Arcturus314/stm_all/logs/approachpiezowaveform/readme

captured using a Saleae Logic 8 on ch1-4 with a 5-1 resistor divider
