Arcturus314/stm_all/logs/Inoise/tianoise.png

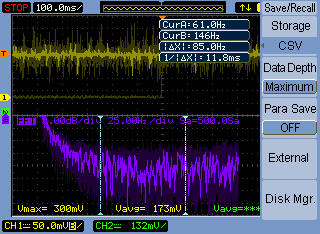
logs/Inoise/tianoise.png
