Arcturus314/stm_all/logs/Inoise_interrupts_duringscan/noshielding.png

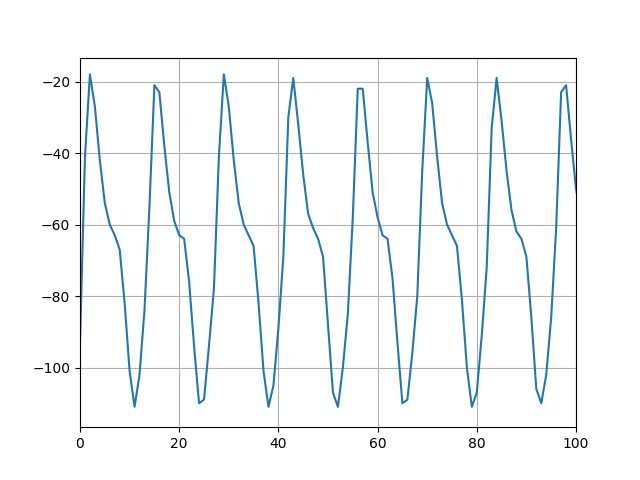
logs/Inoise_interrupts_duringscan/noshielding.png
