Arcturus314/stm_all/logs/Inoise_interrupts_duringscan/shieldedtiacable.png

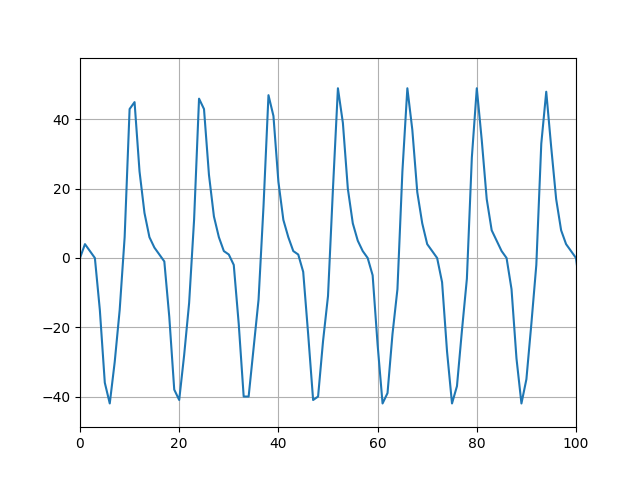
logs/Inoise_interrupts_duringscan/shieldedtiacable.png
