Arcturus314/stm_all/logs/oscilloscope_piezo/SDS00008.png

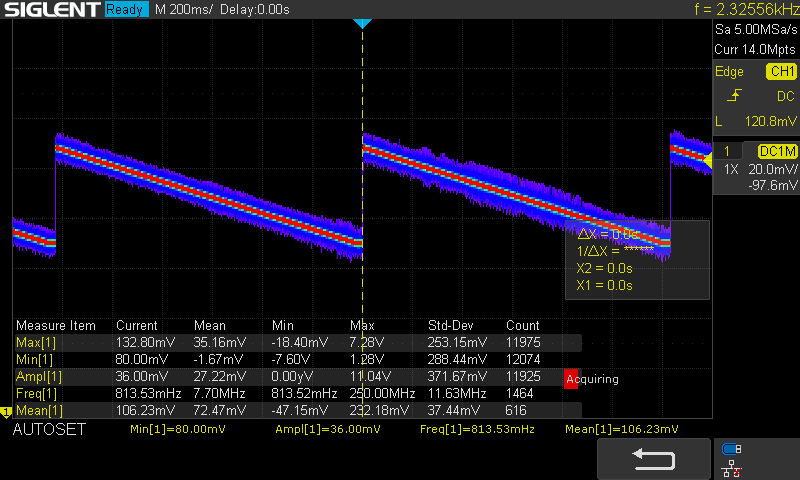
logs/oscilloscope_piezo/SDS00008.png
