Arcturus314/stm_all/logs/oscilloscope_piezo/SDS00009.png

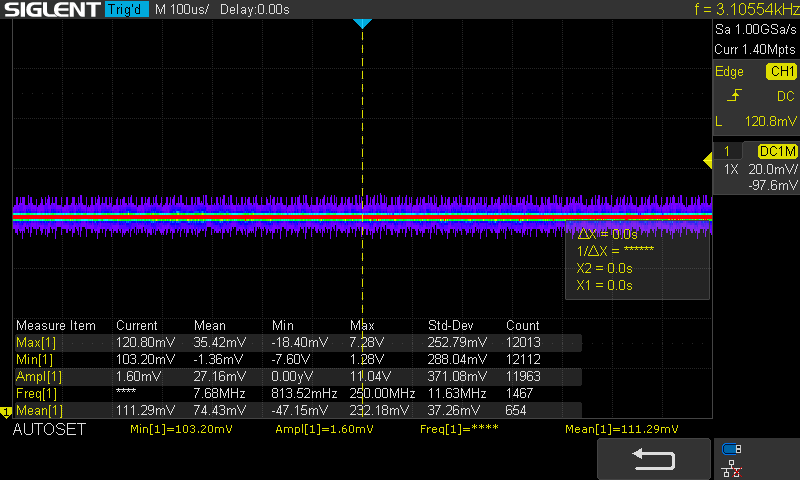
logs/oscilloscope_piezo/SDS00009.png
