Arcturus314/stm_all/logs/oscilloscope_piezo/SDS00010.png

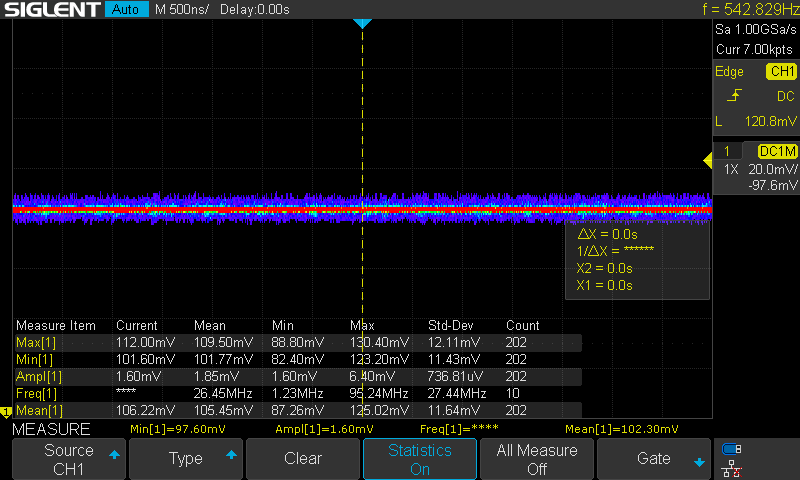
logs/oscilloscope_piezo/SDS00010.png
