Arcturus314/stm_all/logs/oscilloscope_piezo/SDS00011.png

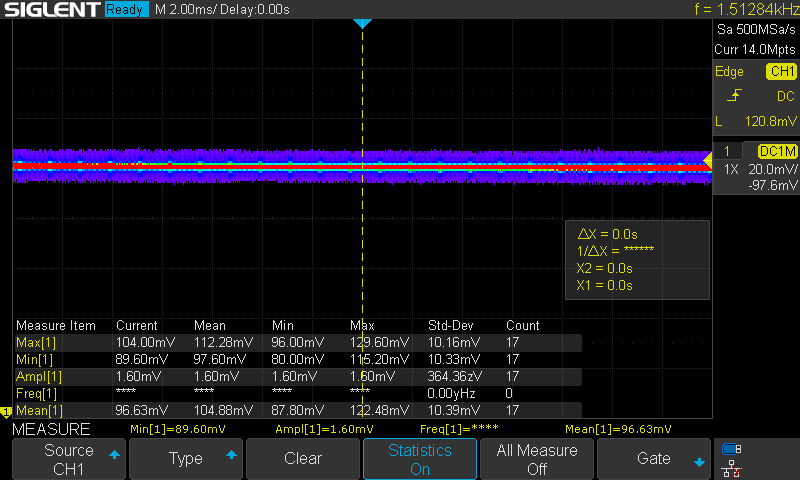
logs/oscilloscope_piezo/SDS00011.png
