Arcturus314/stm_all/logs/oscilloscope_piezo/SDS00012.png

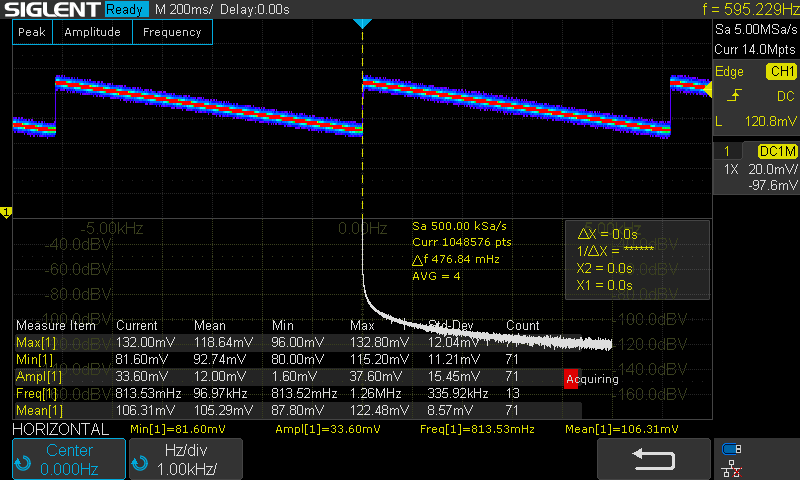
logs/oscilloscope_piezo/SDS00012.png
