Arcturus314/stm_all/logs/oscilloscope_piezo/SDS00013.png

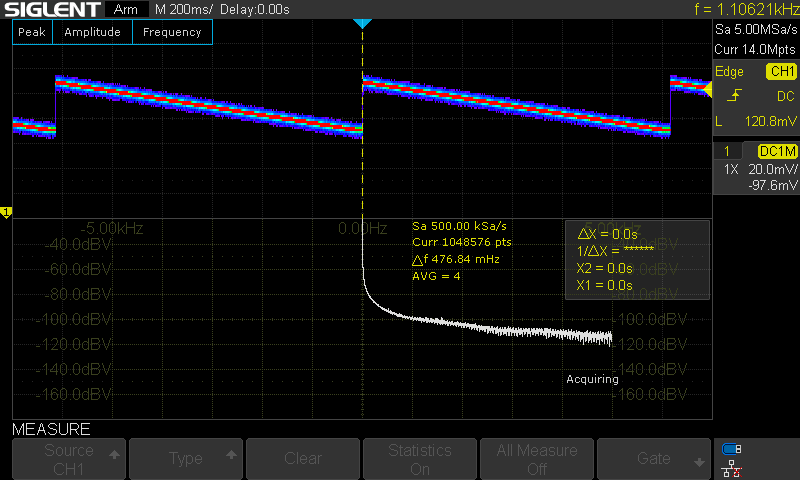
logs/oscilloscope_piezo/SDS00013.png
