Arcturus314/stm_all/logs/oscilloscope_piezo/SDS00014.png

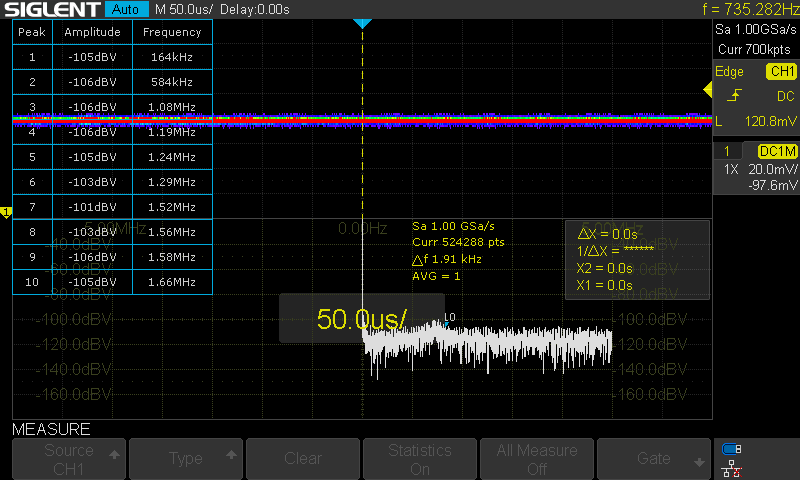
logs/oscilloscope_piezo/SDS00014.png
