Arcturus314/stm_all/logs/oscilloscope_tia/SDS00004.png

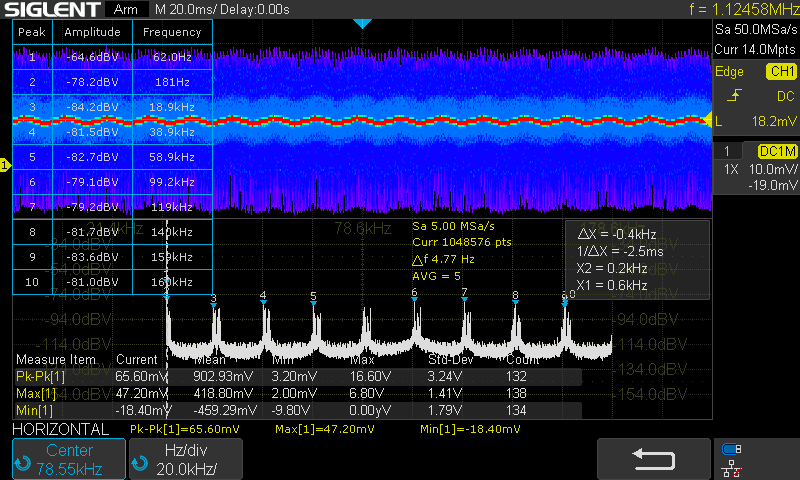
logs/oscilloscope_tia/SDS00004.png
