Arcturus314/stm_all/logs/oscilloscope_tia/SDS00005.png

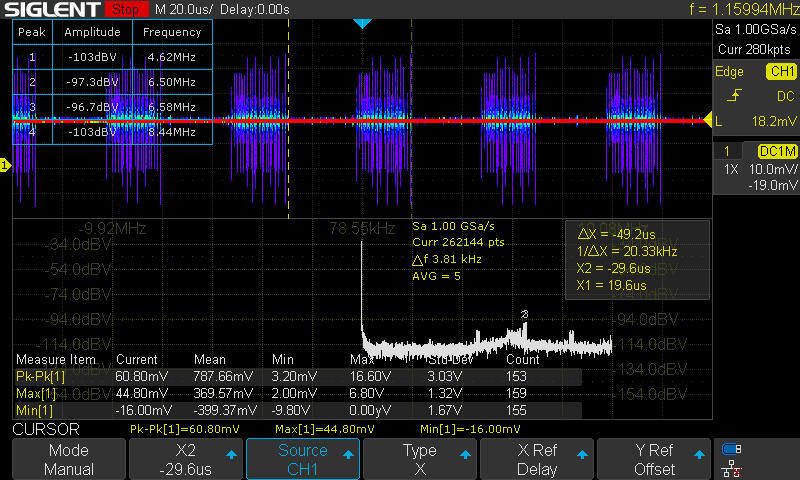
logs/oscilloscope_tia/SDS00005.png
