Arcturus314/stm_all/logs/oscilloscope_tia/SDS00006.png

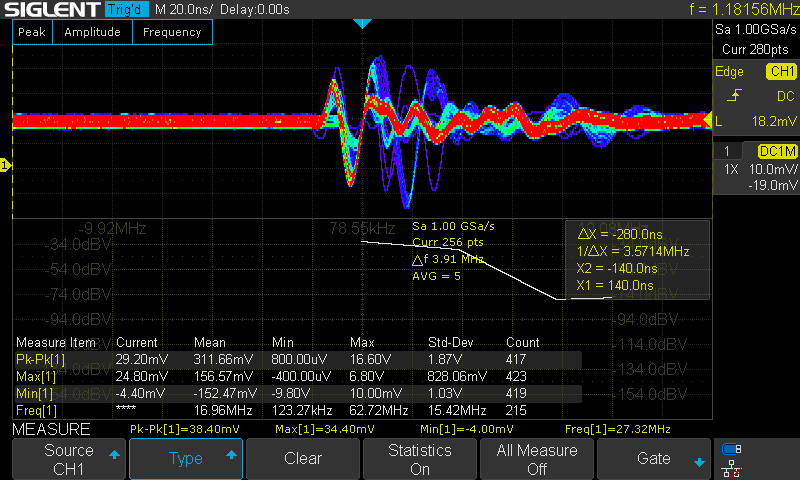
logs/oscilloscope_tia/SDS00006.png
