Arcturus314/stm_all/logs/oscilloscope_tia/SDS00007.png

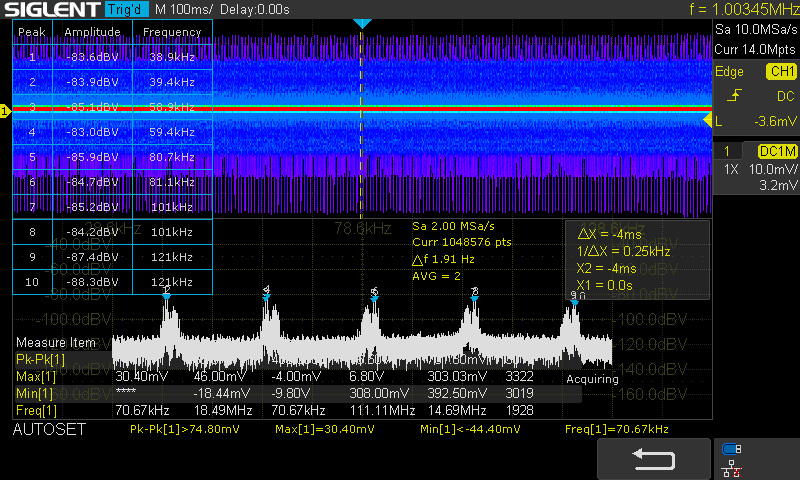
logs/oscilloscope_tia/SDS00007.png
