Arcturus314/stm_all/logs/oscilloscope_tia/TIANOISE.png

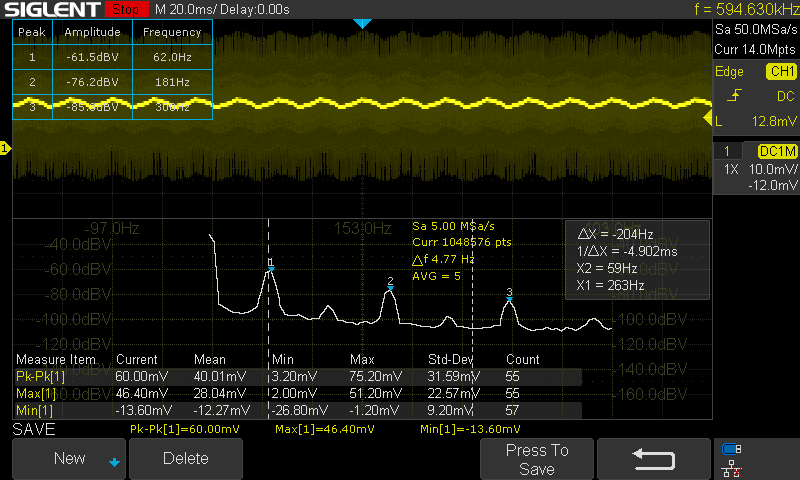
logs/oscilloscope_tia/TIANOISE.png
