Arcturus314/stm_all/stm/highvoltagedriver/IC_Microchip_MIC5281-5.0YMM-TR/eec.models/Microchip_-_MIC5281-5.0YMM-TR.step

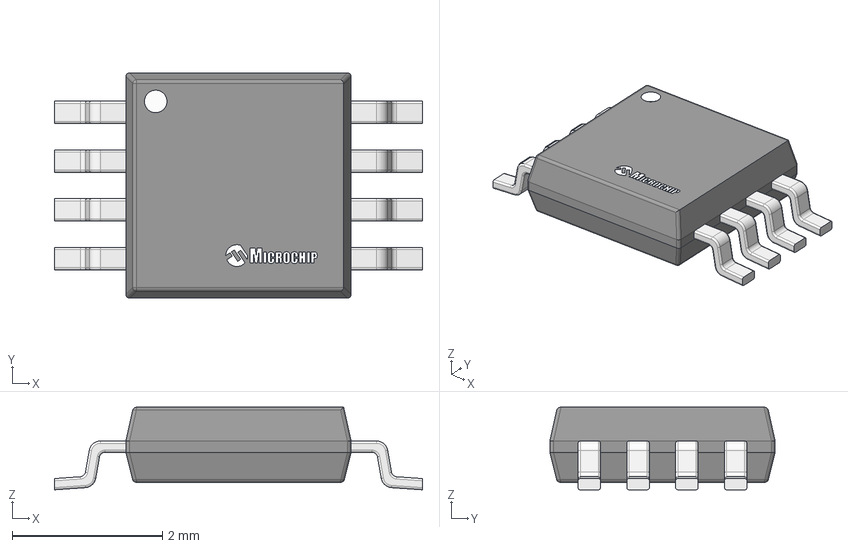
[picture p16: CAD file, 2021-03-22]
stm/highvoltagedriver/IC_Microchip_MIC5281-5.0YMM-TR/eec.models/Microchip_-_MIC5281-5.0YMM-TR.step
4.90 x 3.00 x 1.10 mm
IC_BODY
IC_LEG x 4
circle
Microchip logo
microchip
IC_LEG_MIR11 x 4
