Arcturus314/stm_all/stm/piezodriver/IC_Analog Devices_AD5628BRUZ-1REEL7/eec.models/Analog_Devices_-_AD5628BRUZ-1REEL7.step

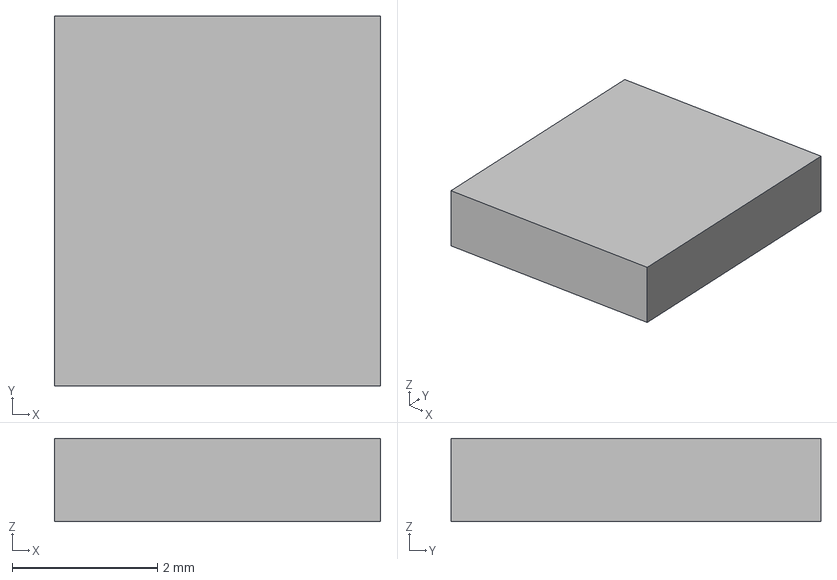
[picture p17: CAD file, 2021-03-22]
stm/piezodriver/IC_Analog Devices_AD5628BRUZ-1REEL7/eec.models/Analog_Devices_-_AD5628BRUZ-1REEL7.step
4.50 x 5.10 x 1.15 mm
