Arcturus314/stm_all/stm/basicpiezodrivercharacterization.xlsx

index | time | minutes | dateTime | voltage | predicted | diff | derivative
0 | 0.05 | 0.0008333333 | 1604285875 | 0 |  | 0
1 | 0.25 | 0.0041666667 | 1604285875 | 0 |  | 0 | 0
2 | 0.44 | 0.0073333333 | 1604285875 | 0 |  | 0 | 0
3 | 0.639 | 0.01065 | 1604285875 | 0 |  | 0 | 0
4 | 0.84 | 0.014 | 1604285876 | 0 |  | 0 | 0
5 | 1.03 | 0.0171666667 | 1604285876 | 0 |  | 0 | 0
6 | 1.229 | 0.0204833333 | 1604285876 | 0 |  | 0 | 0
7 | 1.429 | 0.0238166667 | 1604285876 | 0 |  | 0 | 0
8 | 1.607 | 0.0267833333 | 1604285876 | 0 |  | 0 | 0
9 | 1.807 | 0.0301166667 | 1604285877 | 0 |  | 0 | 0
10 | 2.007 | 0.03345 | 1604285877 | 0 |  | 0 | 0
11 | 2.199 | 0.03665 | 1604285877 | 0 |  | 0 | 0
12 | 2.39 | 0.0398333333 | 1604285877 | 0 |  | 0 | 0
13 | 2.597 | 0.0432833333 | 1604285877 | 0 |  | 0 | 0
14 | 2.797 | 0.0466166667 | 1604285878 | 0 |  | 0 | 0
15 | 2.987 | 0.0497833333 | 1604285878 | 0 |  | 0 | 0
16 | 3.184 | 0.0530666667 | 1604285878 | 0 |  | 0 | 0
17 | 3.376 | 0.0562666667 | 1604285878 | 0 |  | 0 | 0
18 | 3.585 | 0.05975 | 1604285878 | 0 |  | 0 | 0
19 | 3.778 | 0.0629666667 | 1604285879 | 0.004 |  | 0.004 | 0.004
20 | 3.983 | 0.0663833333 | 1604285879 | 0.004 |  | 0.004 | 0
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
