Arcturus314/stm_all/stm/testscripts/v2tiatest.xlsx

0.27403656 | 0.2742864219 | test, 5 samples | test, 1 sample | 0.05393 | 0.26965 | 0.27090908 | no current | 0.27535 | 0.274225 | 10mohm@3v | 0.58202 | 0.5878529666 | 0.3136279666 | v delta
0.2717807 | 0.00165688766 |  |  | 0.05379 | 0.26895 | 0.001996764405 |  | 0.26393 | 0.009566550505 |  | 0.57813 | 0.008707352292
0.2748825 |  |  |  | 0.05473 | 0.27365 |  |  | 0.27585 |  |  | 0.58998 |  | expect… | 1mohm gain resistor
0.27530548 |  |  |  | 0.05441 | 0.27205 |  |  | 0.28614 |  |  | 0.58845 |  |  | current | 3e-07
0.27174041 |  |  |  | 0.05349 | 0.26745 |  |  | 0.26197 |  |  | 0.57803 |  |  | v delta | 0.3
0.27458039 | 44.37822491 |  |  | 0.05415 | 0.27075 | 42.6499347 |  | 0.27581 | 29.14703353 |  | 0.591 | 36.58765196
0.2765744 |  |  |  | 0.05471 | 0.27355 |  |  | 0.29059 |  |  | 0.60081 |  | nice! Looks good
0.27359346 |  |  |  | 0.05399 | 0.26995 |  |  | 0.26747 |  |  | 0.57477
0.27262664 |  |  |  | 0.05421 | 0.27105 |  |  | 0.27474 |  |  | 0.59203
0.27474153 |  |  |  | 0.05381 | 0.26905 |  |  | 0.28582 |  |  | 0.59832
0.27675569 |  |  |  | 0.05399 | 0.26995 |  |  | 0.2694 |  |  | 0.58156 |  | can currently resolve
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
