Arcturus314/stm_all/stm/frontendamp/frontendfullv2/frontendfullv2/frontendfull_lm7721/schematics.pdf

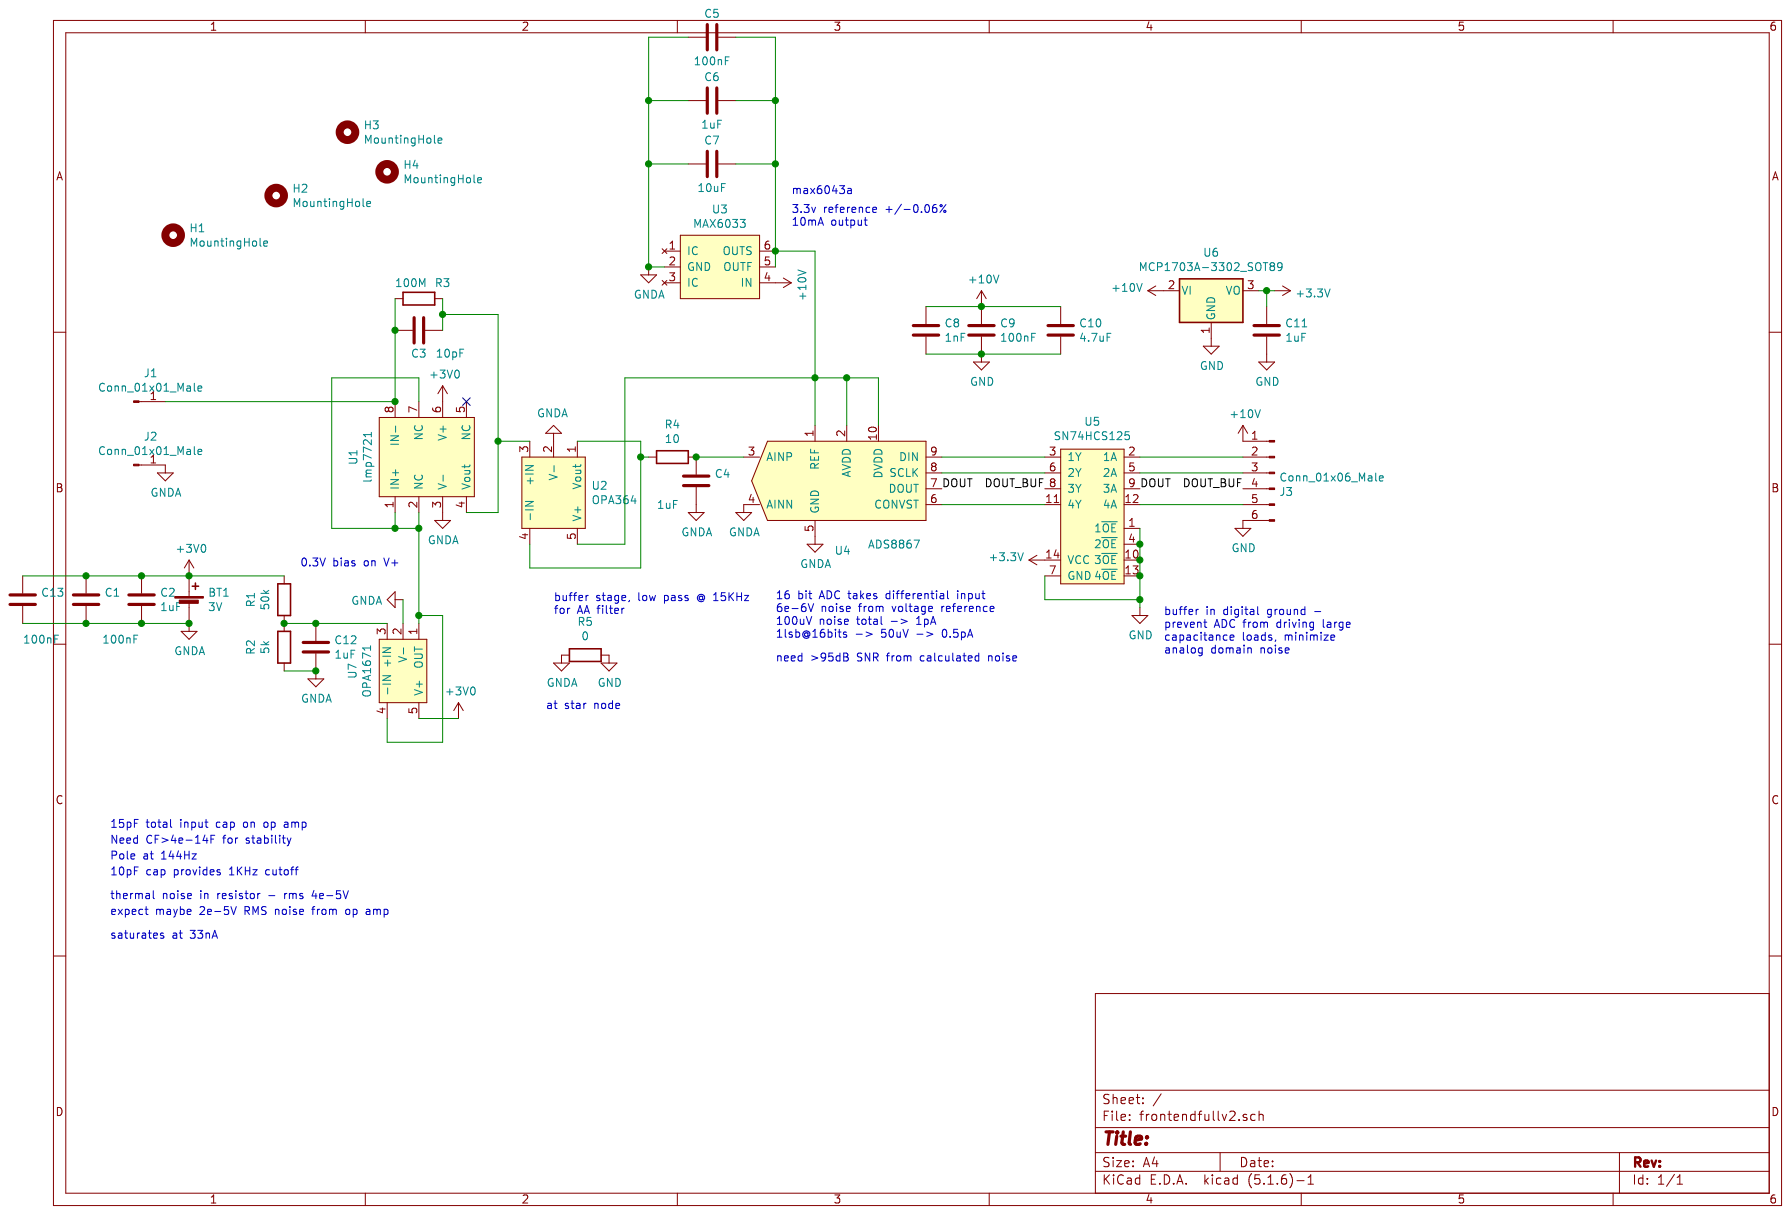
[picture p18: page 1]
