Arcturus314/stm_all/stm/highvoltagedriver/schem.pdf

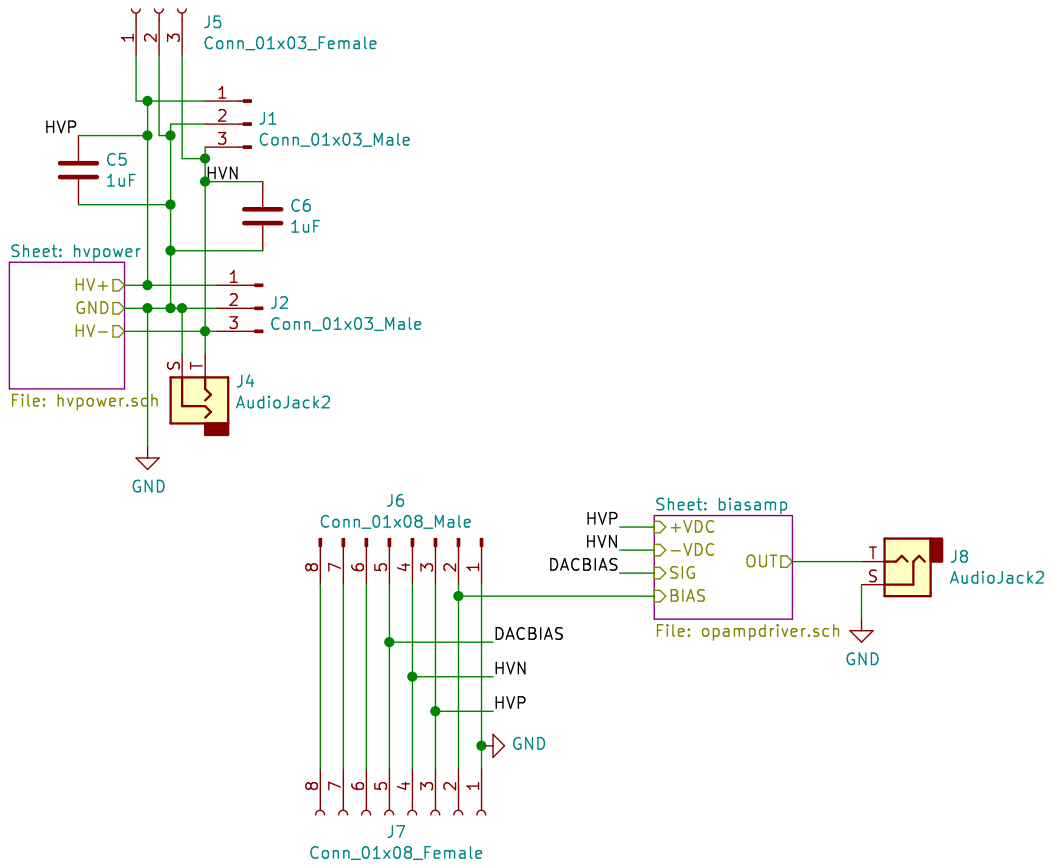
[picture p19: page 1]

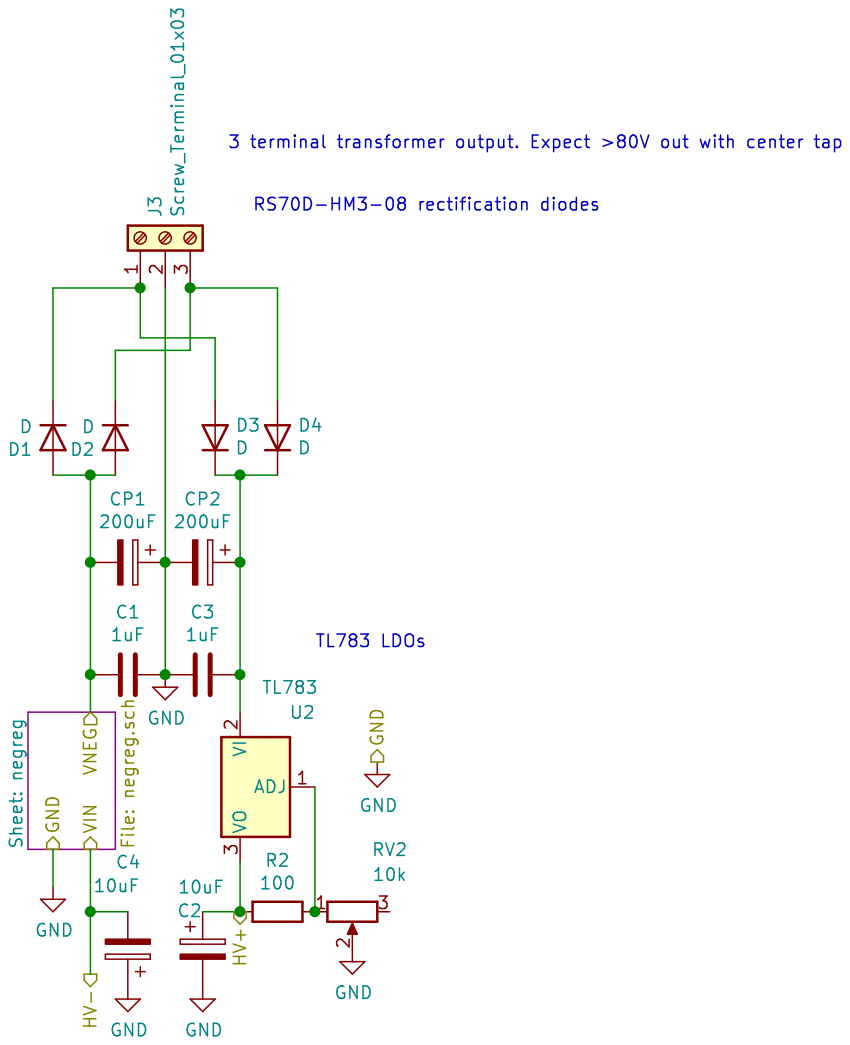
[picture p20: page 2]

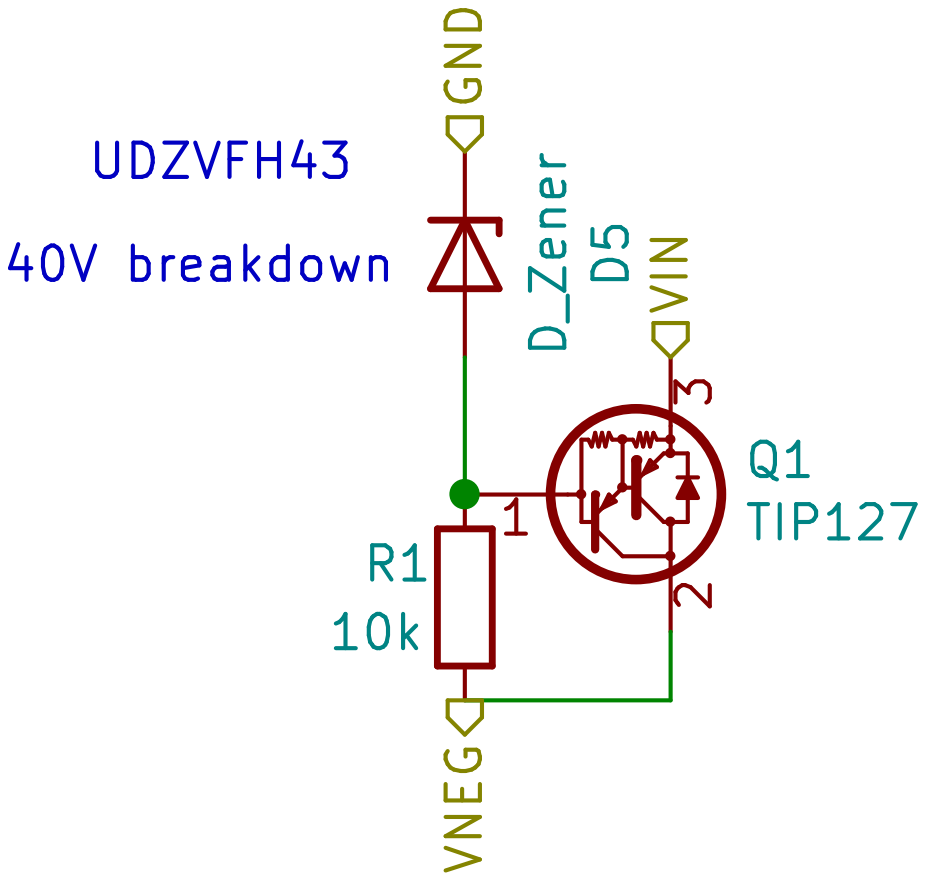
[picture p21: page 3]

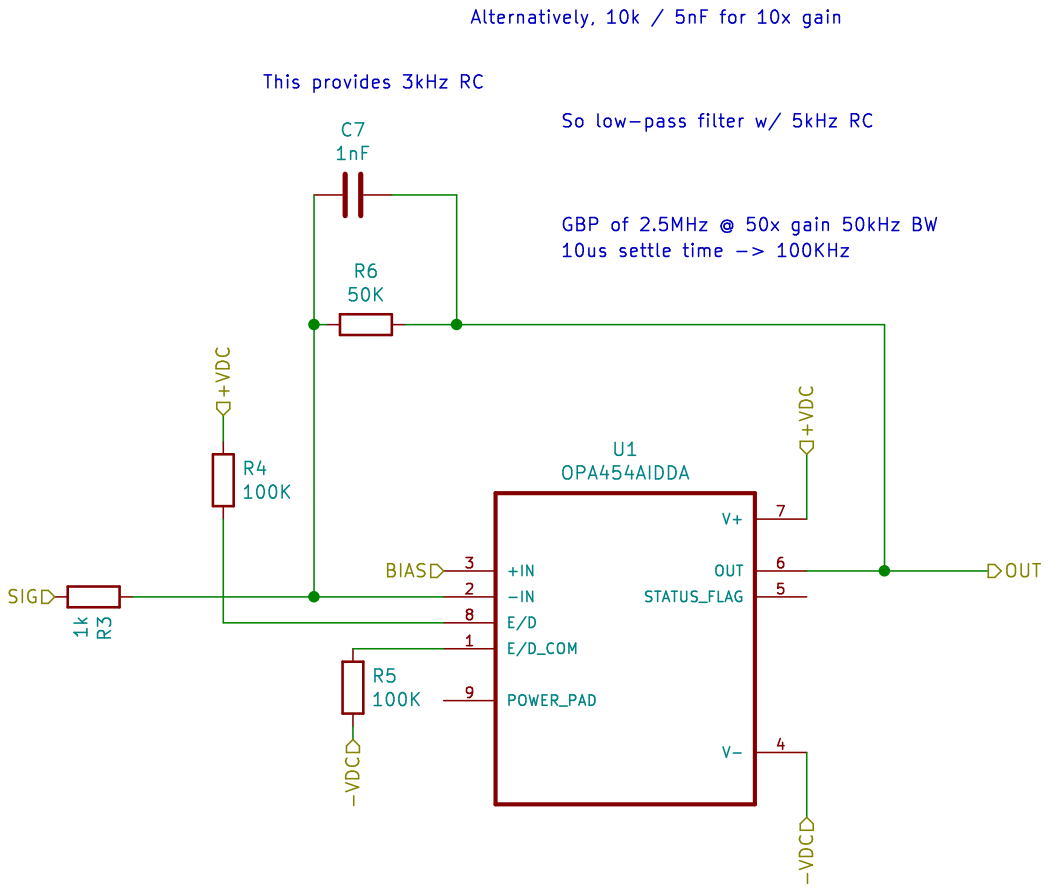
[picture p22: page 4]
