Arcturus314/stm_all/stm/highvoltagedriver/schemamp.pdf

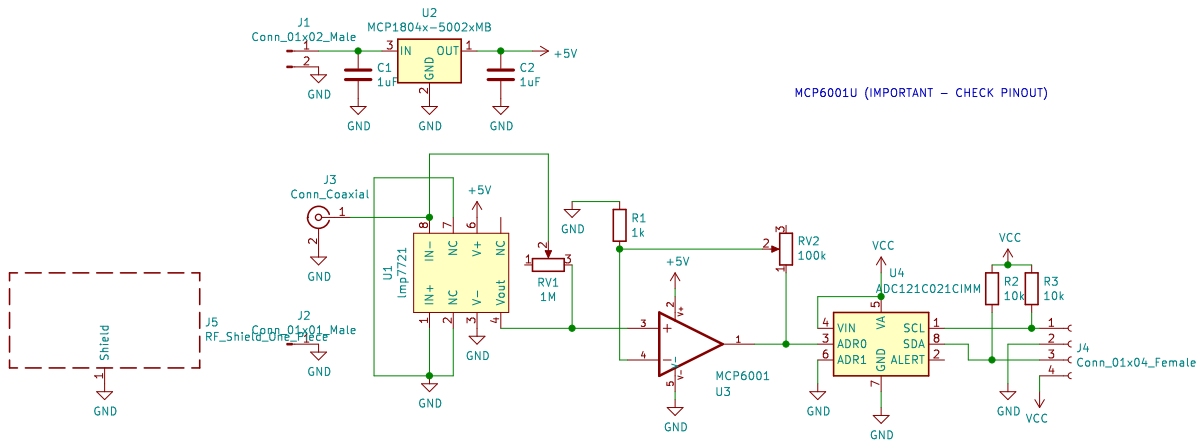
[picture p23: page 1]
