Arcturus314/stm_all/stm/highvoltagedriver/schempiezo.pdf

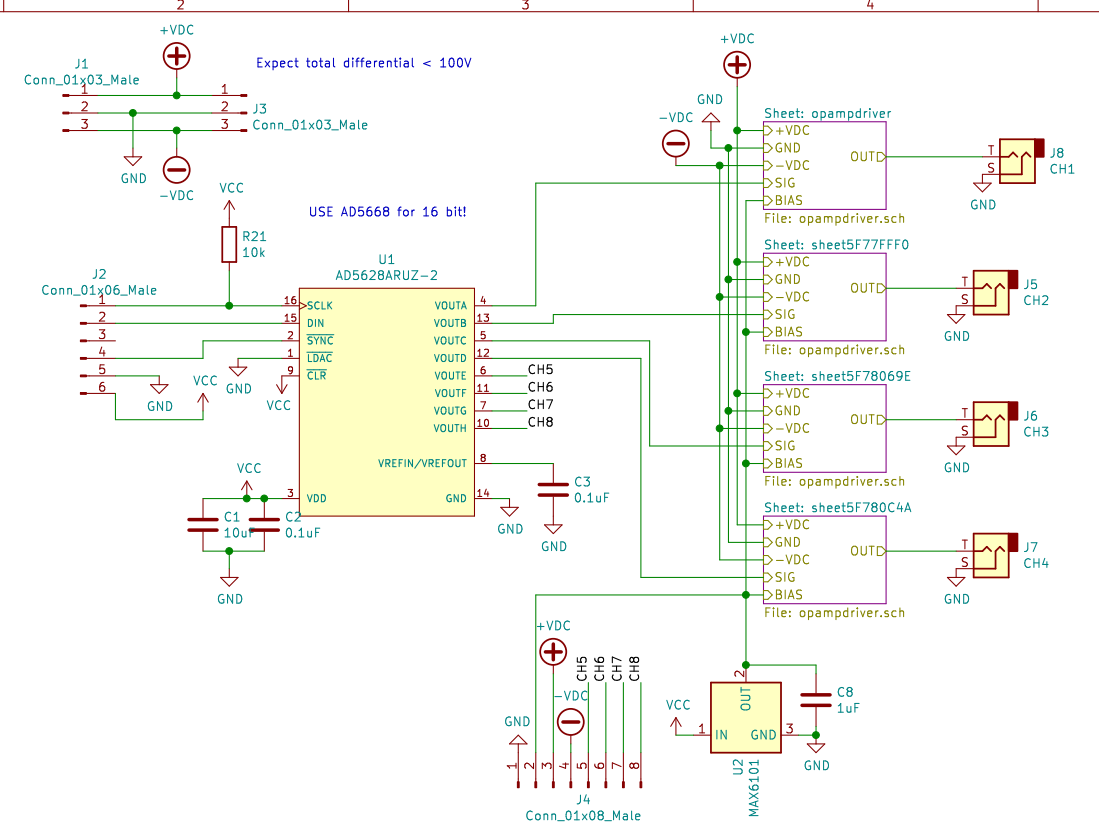
[picture p24: page 1]

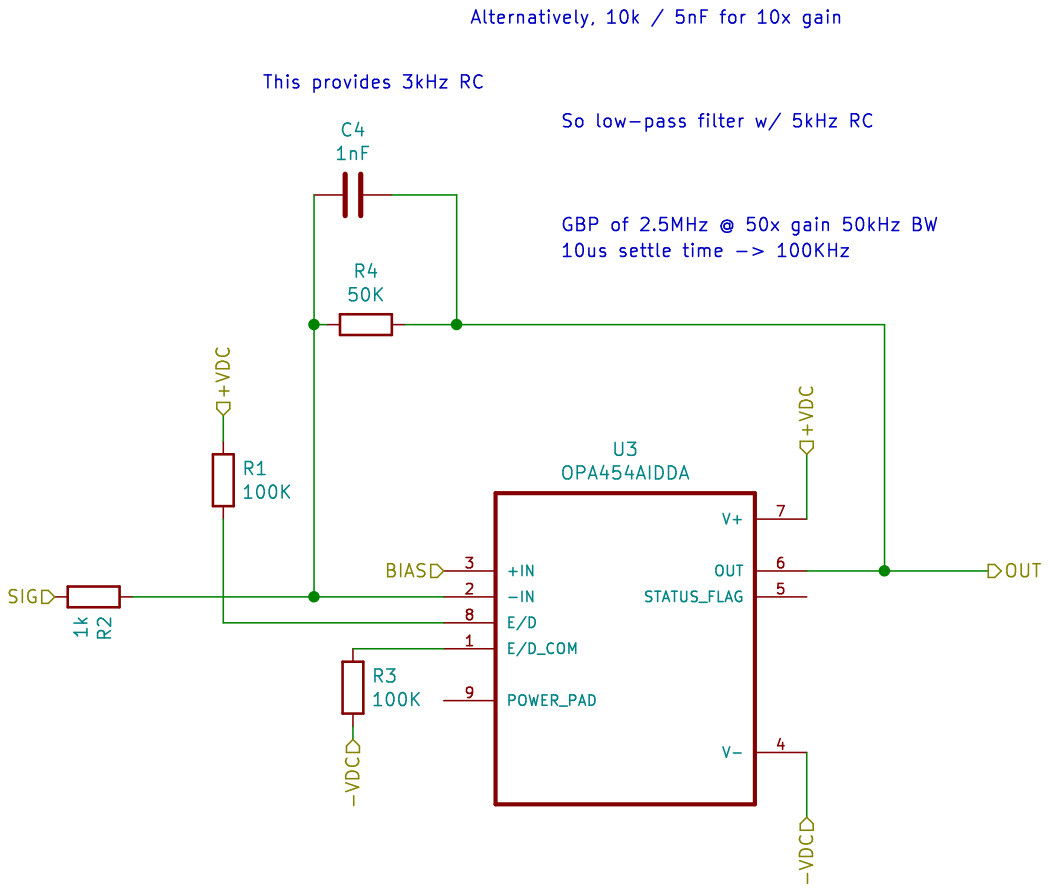
[picture p25: page 2]

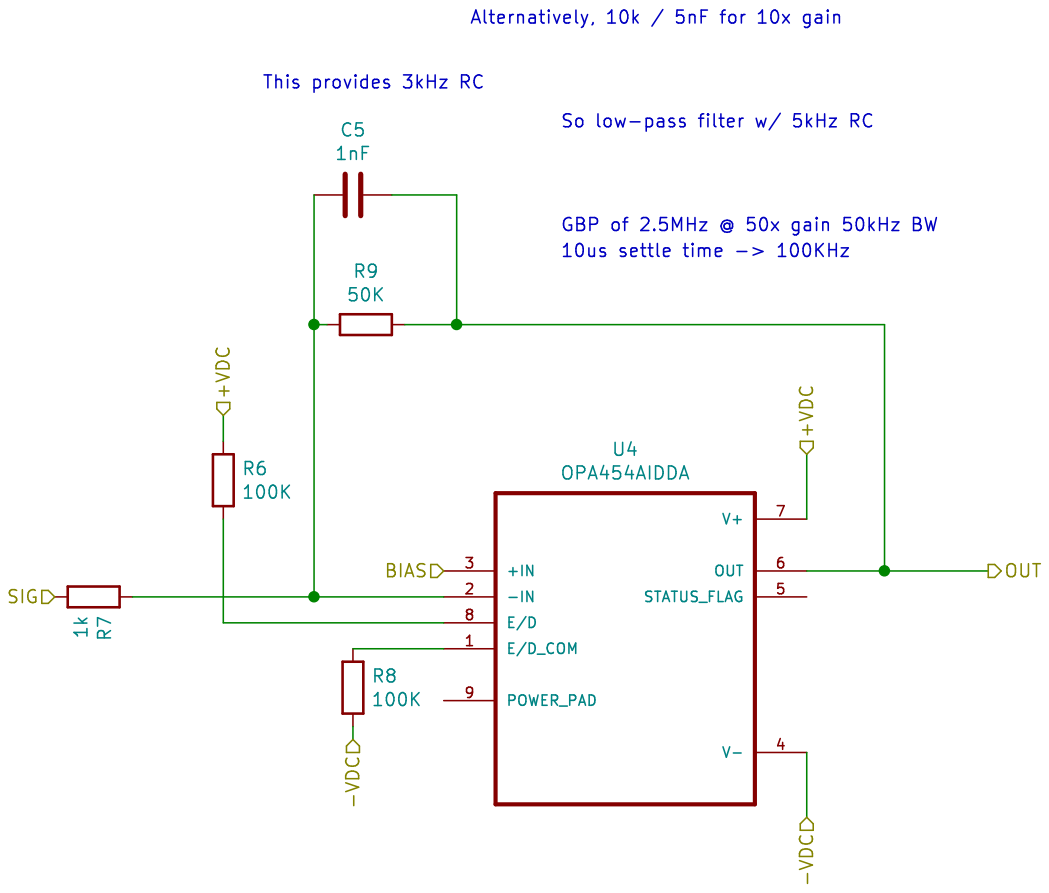
[picture p26: page 3]

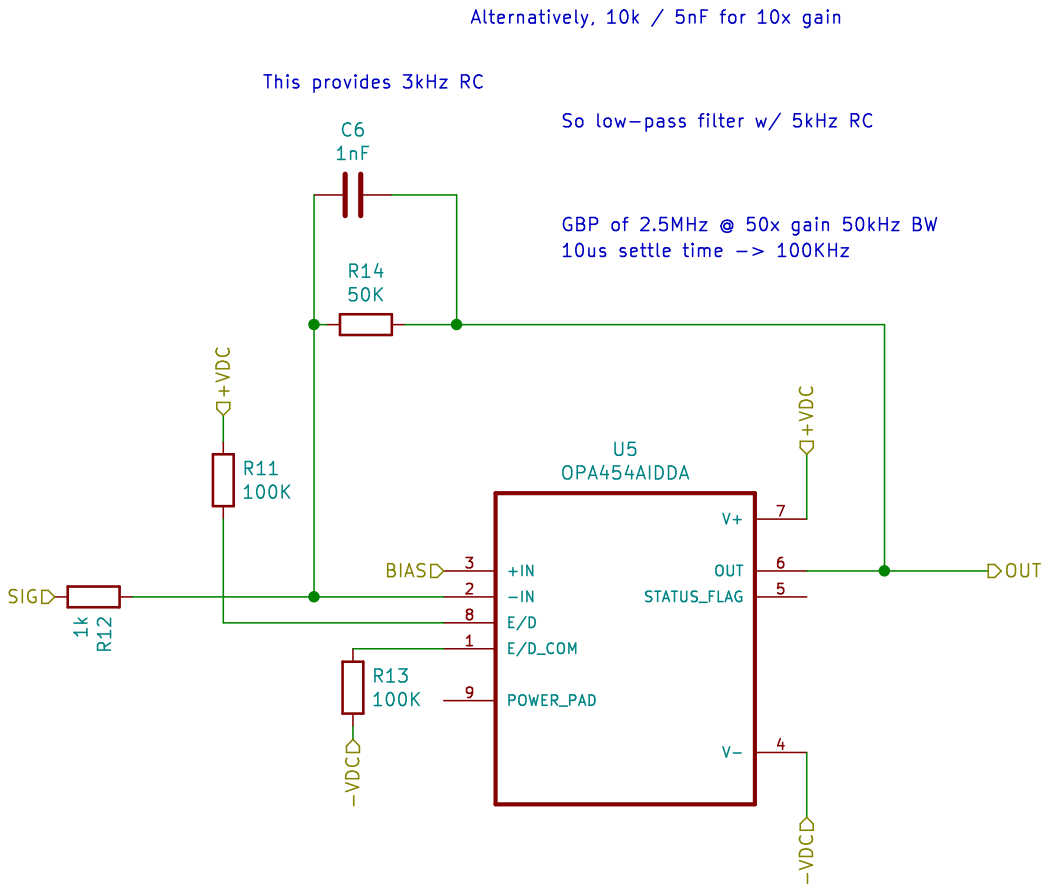
[picture p27: page 4]

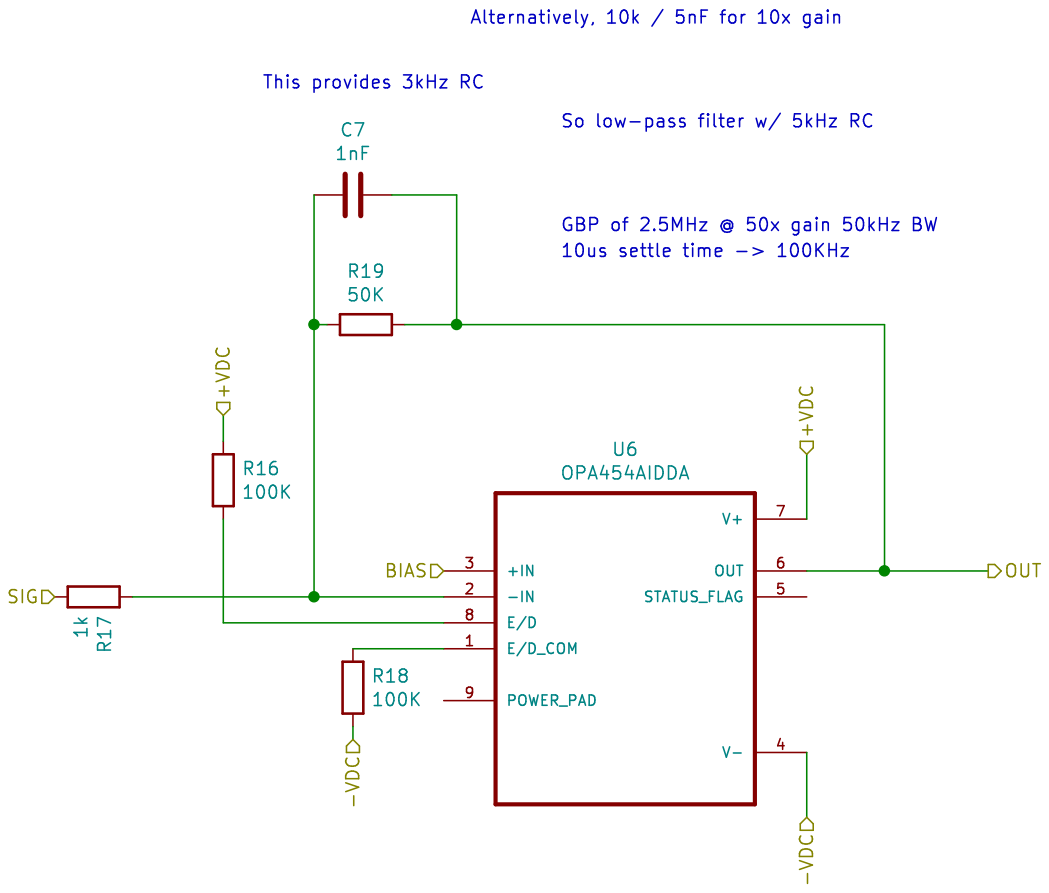
[picture p28: page 5]
