Arcturus314/stm_all/stm/userinterfacepcb/userinterfaceschem.pdf

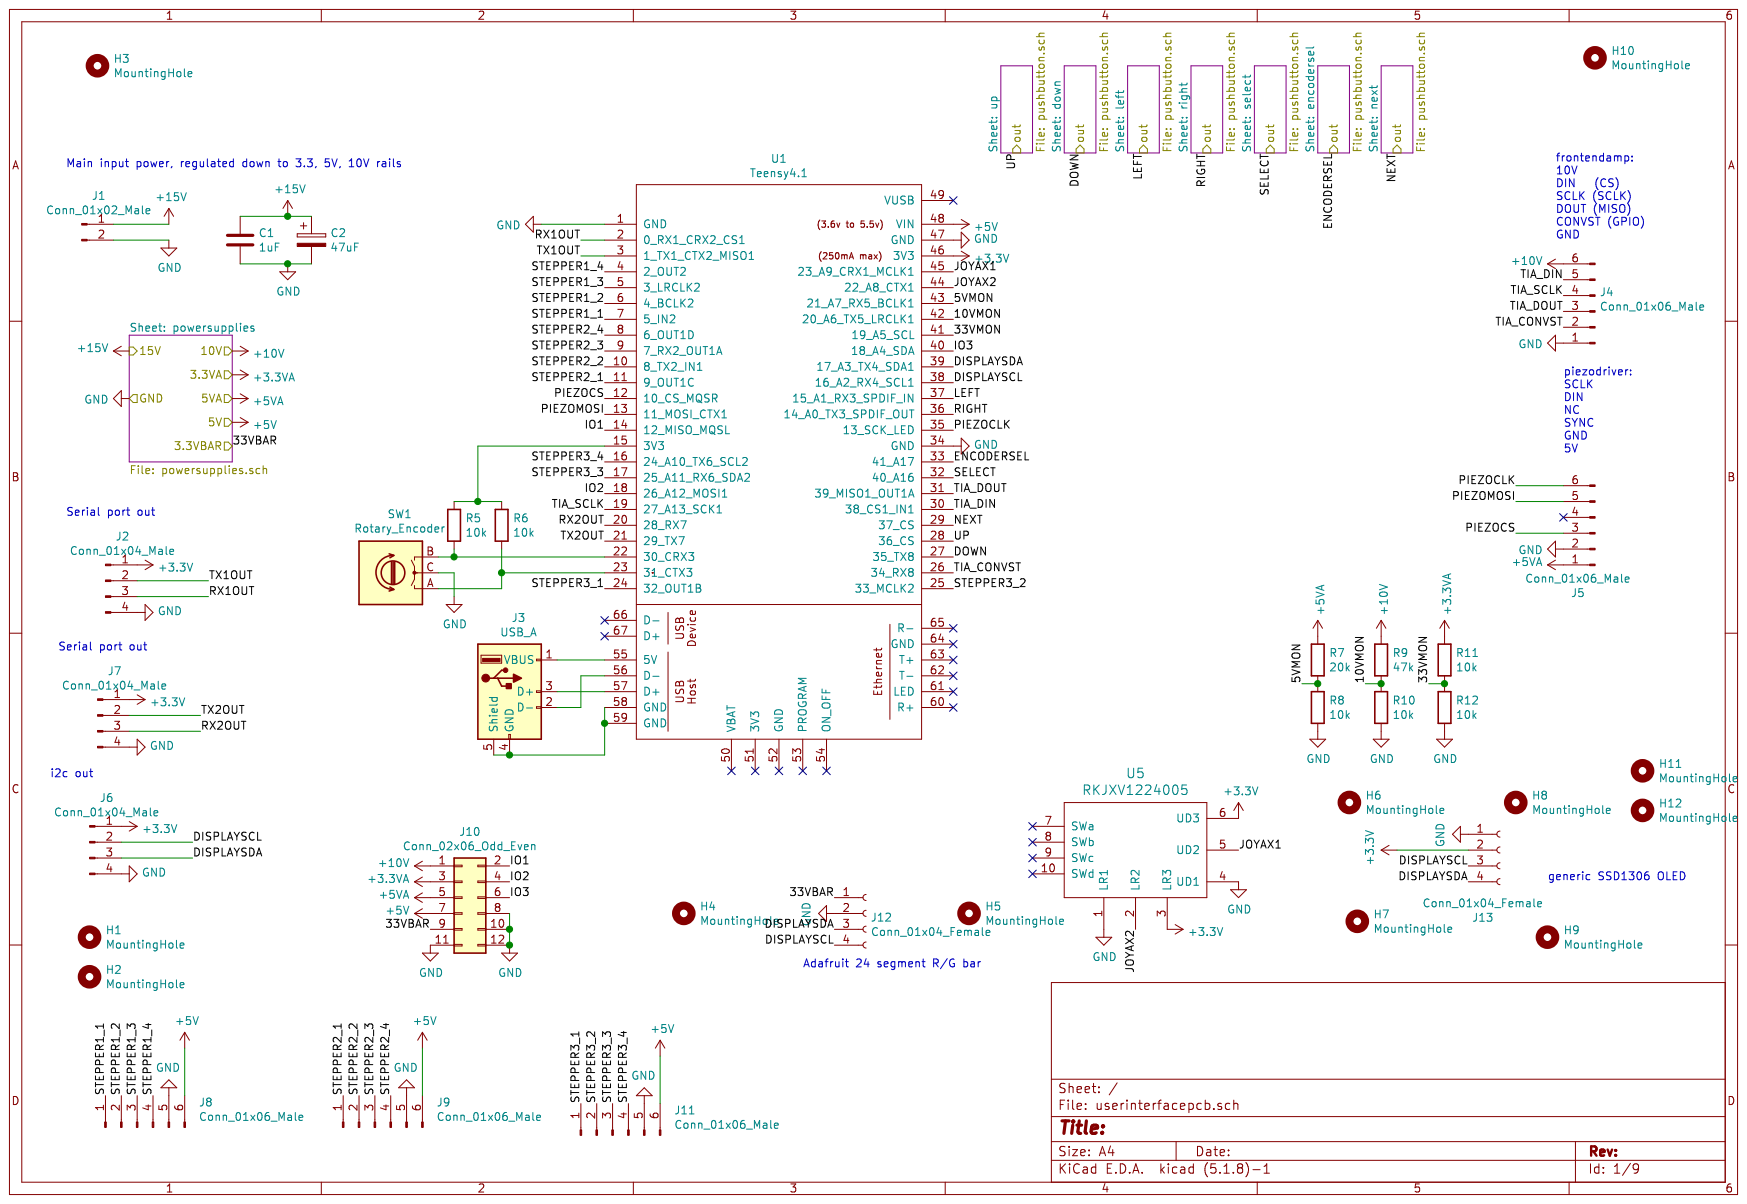
[picture p35: page 1]

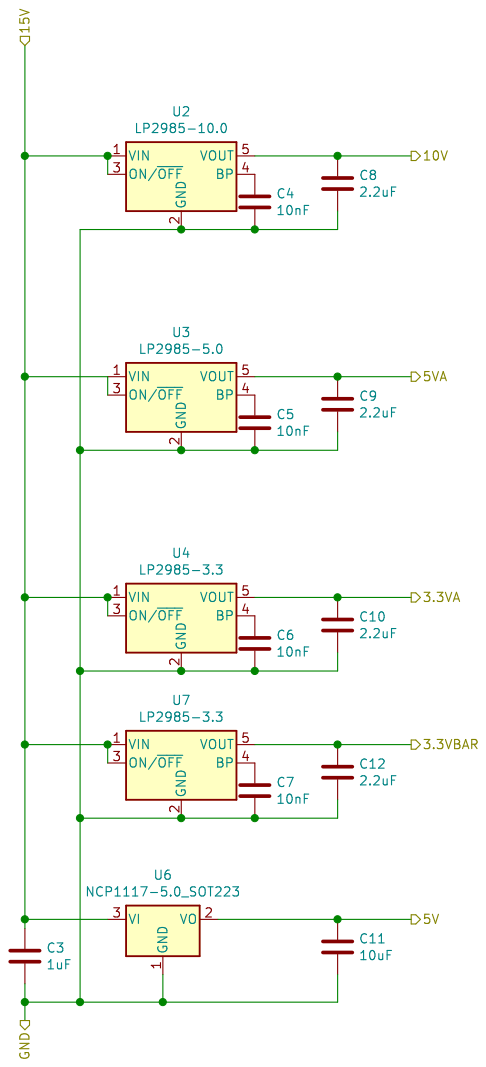
[picture p36: page 2]

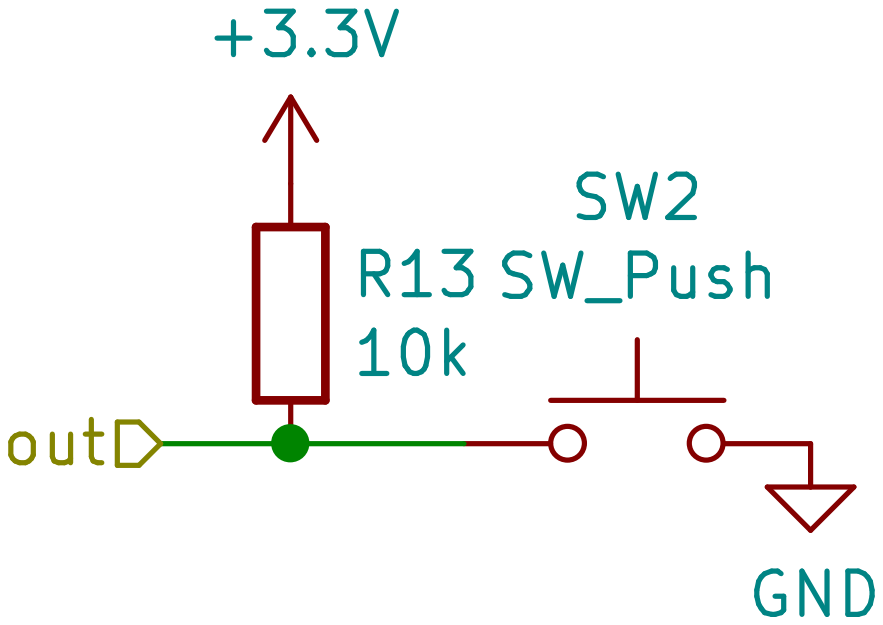
[picture p37: page 3]

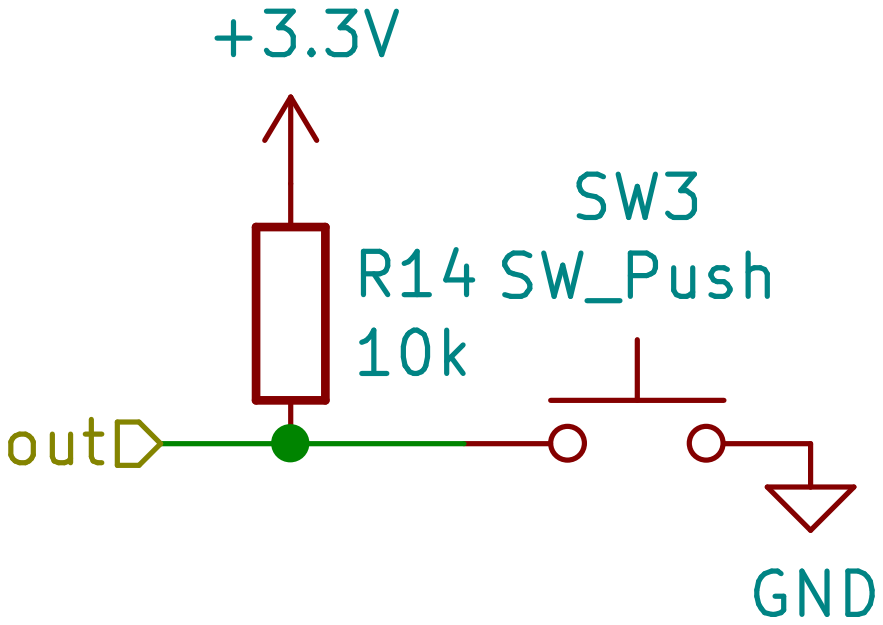
[picture p38: page 4]

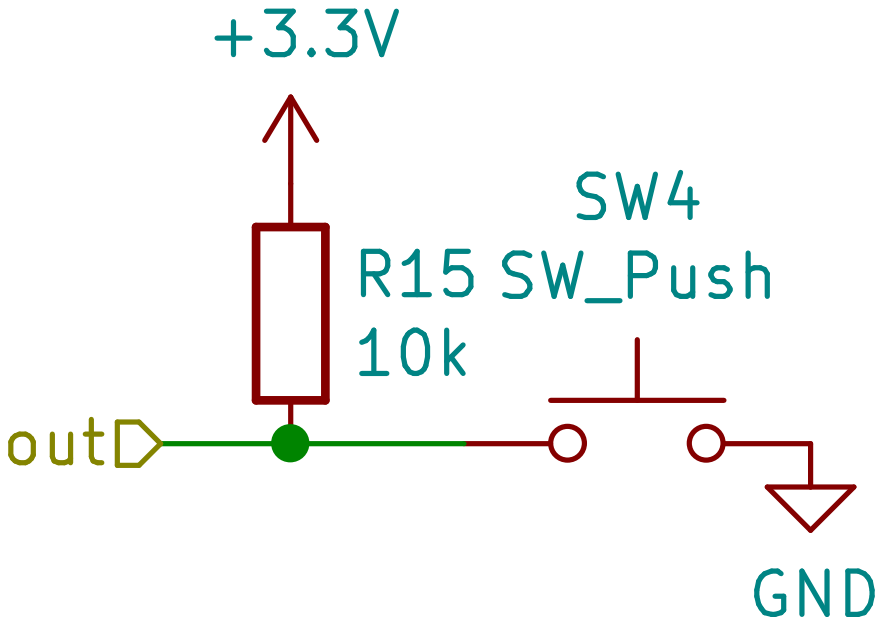
[picture p39: page 5]

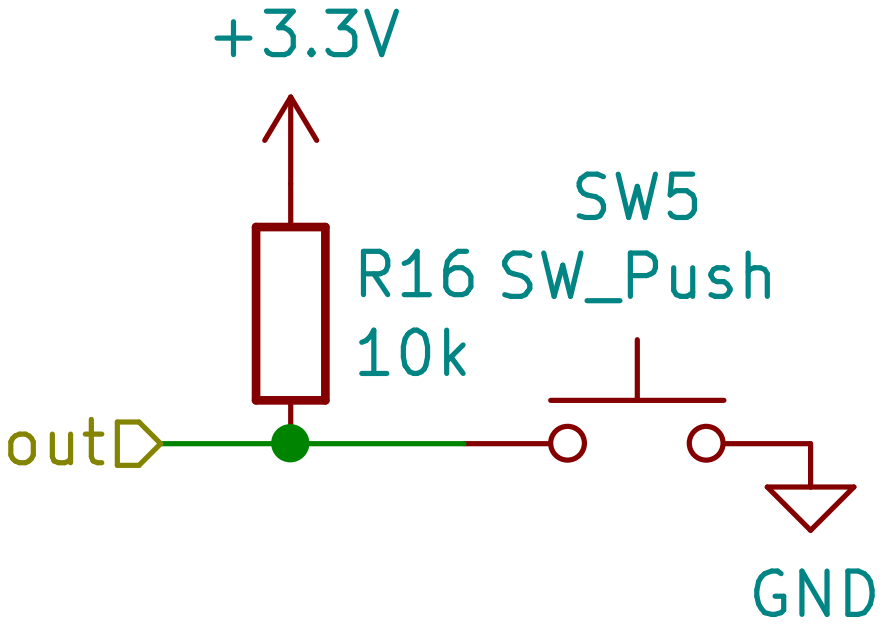
[picture p40: page 6]

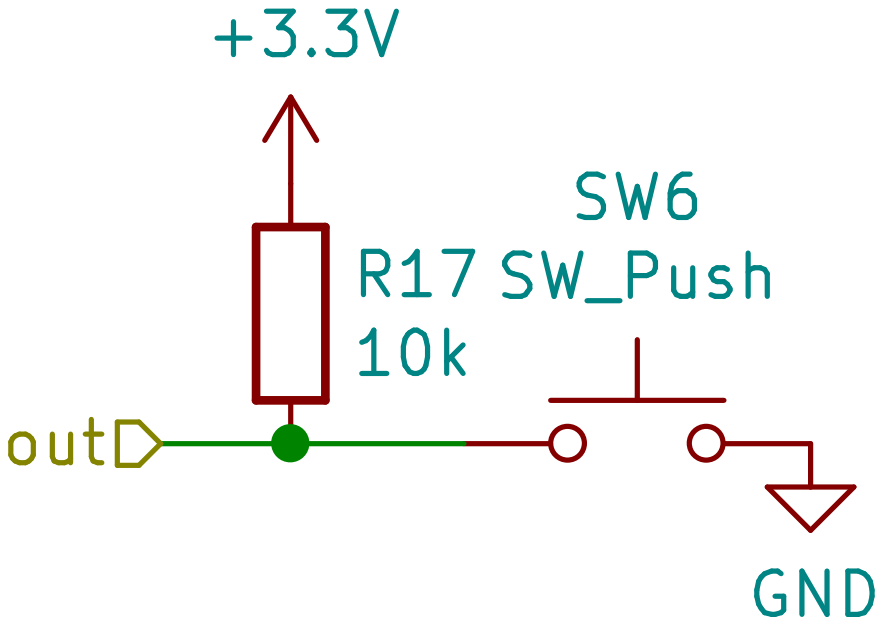
[picture p41: page 7]

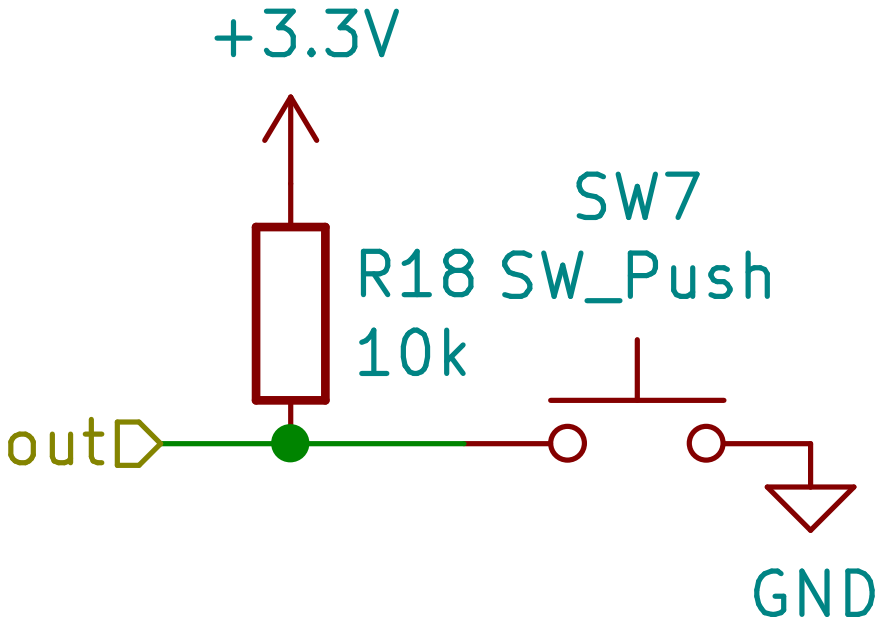
[picture p42: page 8]

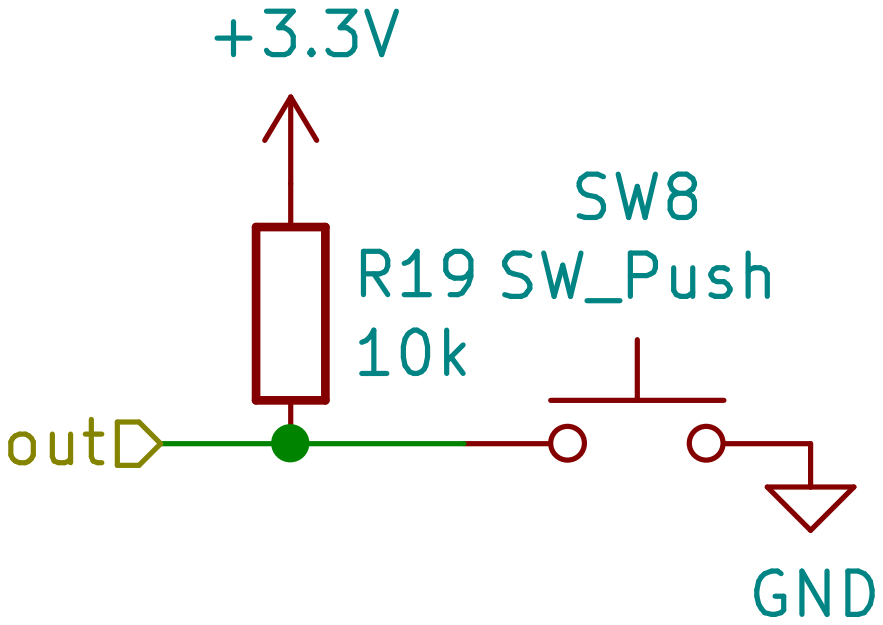
[picture p43: page 9]
