Arcturus314/stm_all/(list of files, drawings)

Other design files:
stm/userinterfacepcb/userinterfacepcb.dsn
