Arcturus314/stm_all/stm/piezodriverv2/piezodriver.kicad_pcb

## KiCad design stm/piezodriverv2/piezodriver.kicad_pcb (2021-03-22)

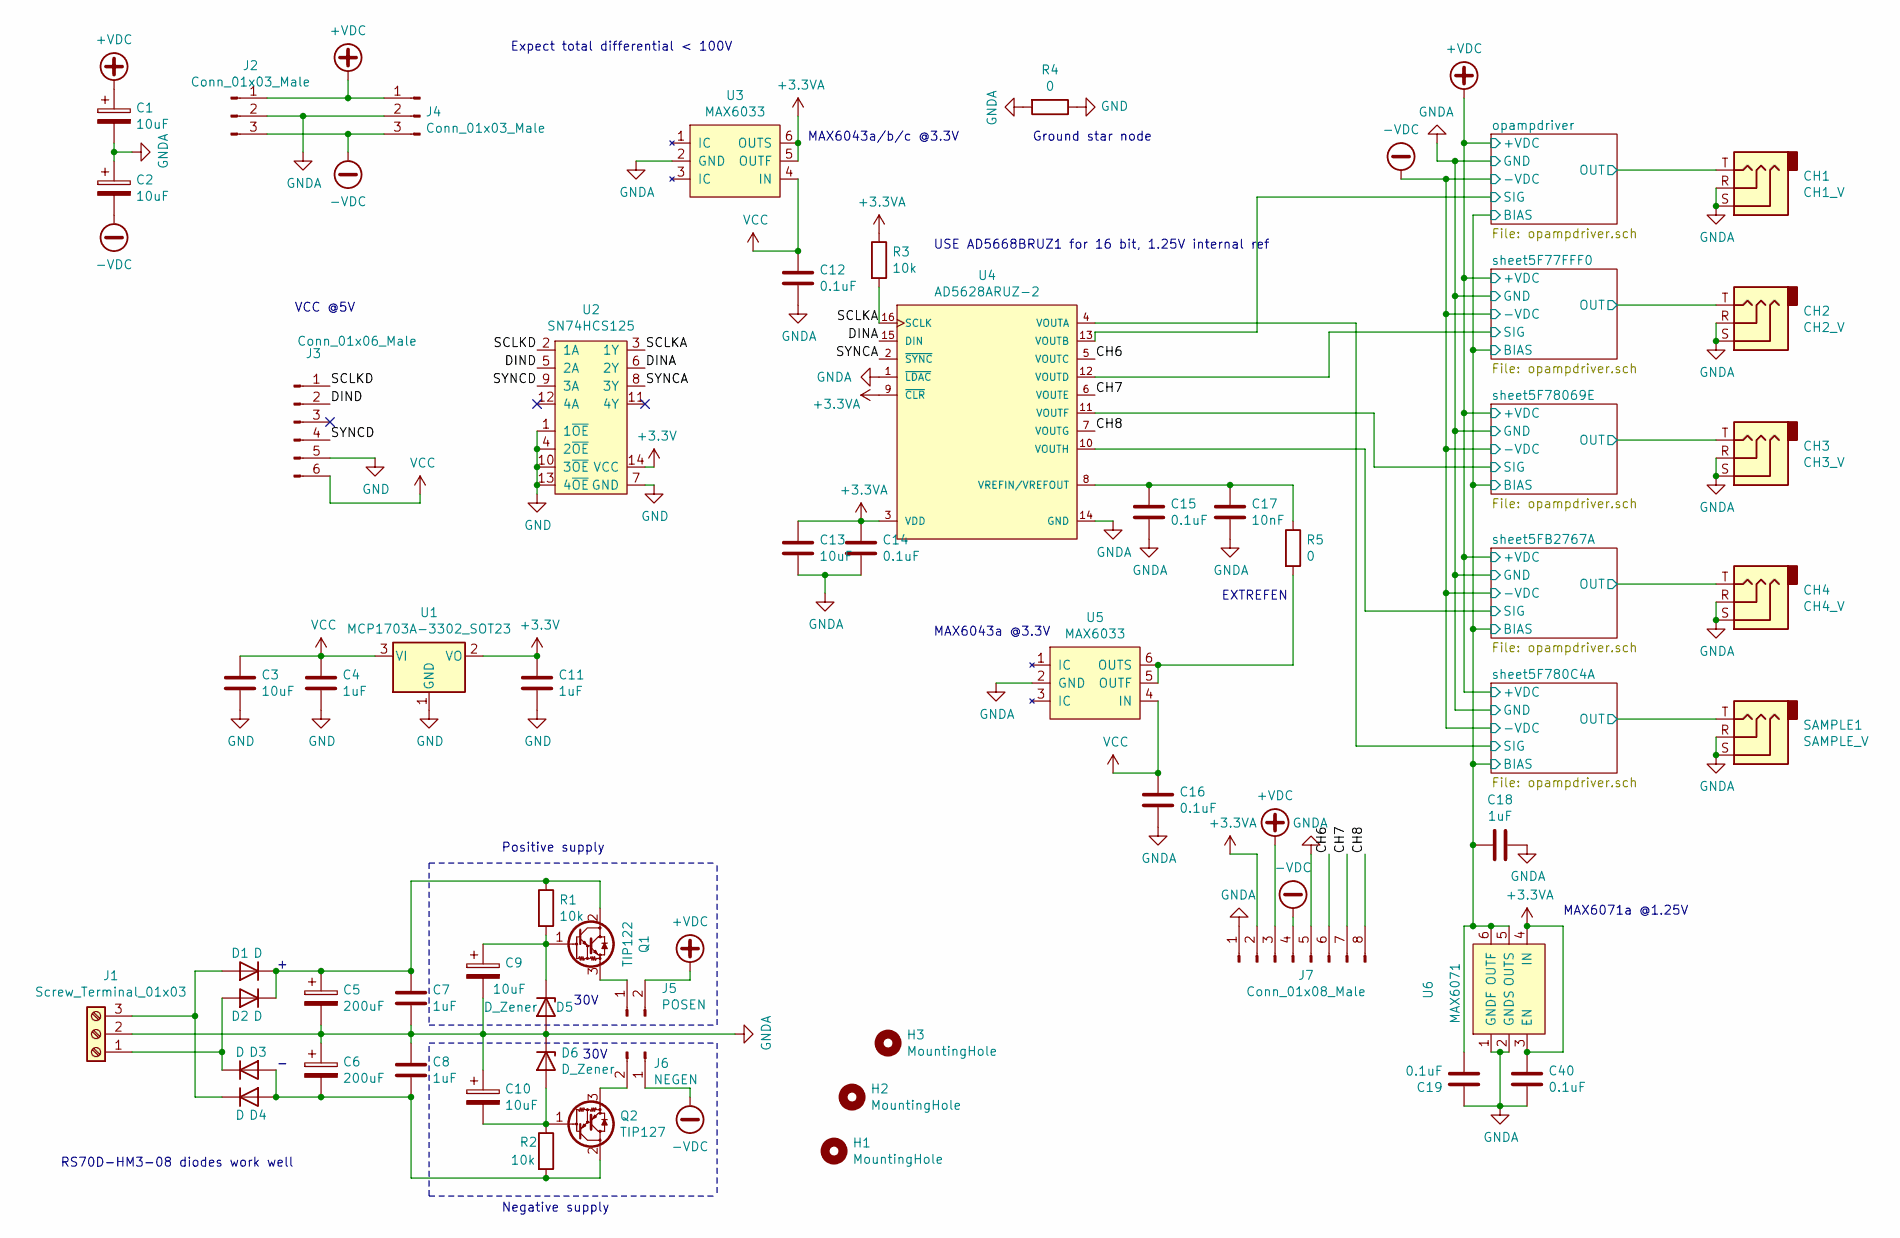
[picture p44: schematic piezodriver.sch]

Parts:
C1, C2, C9, C10: 10uF; CP_Radial_D5.0mm_P2.50mm
C3, C13: 10uF; C_0805_2012Metric_Pad1.18x1.45mm_HandSolder
C4, C7, C8, C11, C18: 1uF; C_0805_2012Metric_Pad1.18x1.45mm_HandSolder
C5, C6: 200uF; CP_Radial_D12.5mm_P5.00mm
C12, C14, C15, C16, C19, C40: 0.1uF; C_0805_2012Metric_Pad1.18x1.45mm_HandSolder
C17: 10nF; C_0805_2012Metric_Pad1.18x1.45mm_HandSolder
CH1: CH1_V; Jack_3.5mm_CUI_SJ-3523-SMT_Horizontal
CH2: CH2_V; Jack_3.5mm_CUI_SJ-3523-SMT_Horizontal
CH3: CH3_V; Jack_3.5mm_CUI_SJ-3523-SMT_Horizontal
CH4: CH4_V; Jack_3.5mm_CUI_SJ-3523-SMT_Horizontal
D1, D2, D3, D4: D; D_SMF
D5, D6: D_Zener; D_SOD-323_HandSoldering
H1, H2, H3: MountingHole; MountingHole_3.2mm_M3
J1: Screw_Terminal_01x03; TerminalBlock_Phoenix_MKDS-1,5-3-5.08_1x03_P5.08mm_Horizont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
J2, J4: Conn_01x03_Male; PinHeader_1x03_P2.54mm_Vertical
J3: Conn_01x06_Male; PinHeader_1x06_P2.54mm_Vertical
J5: POSEN; PinHeader_1x02_P2.54mm_Vertical
J6: NEGEN; PinHeader_1x02_P2.54mm_Vertical
J7: Conn_01x08_Male; PinHeader_1x08_P2.54mm_Vertical
Q1: TIP122; TO-220-3_Vertical
Q2: TIP127; TO-220-3_Vertical
R1, R2, R3: 10k; R_0805_2012Metric_Pad1.20x1.40mm_HandSolder
R4, R5: 0; R_0805_2012Metric_Pad1.20x1.40mm_HandSolder
SAMPLE1: SAMPLE_V; Jack_3.5mm_CUI_SJ-3523-SMT_Horizontal
U1: MCP1703A-3302_SOT23; SOT-23
U2: SN74HCS125; TSSOP-14_4.4x5mm_P0.65mm
U3, U5: MAX6033; SOT-23-6_Handsoldering
U4: AD5628ARUZ-2; TSSOP-16_4.4x5mm_P0.65mm
U6: MAX6071; SOT-23-6_Handsoldering

Connections:
+3.3VA: C13.1, C14.1, C40.1, J7.2, R3.1, U3.5 (OUTF), U3.6 (OUTS), U4.3 (VDD), U4.9 (~CLR~), U6.3 (EN), U6.4 (IN)
+3V3: C11.1, U1.2 (VO), U2.14 (VCC)
+VDC: C1.1, J2.1, J4.1, J5.2, J7.3; also elsewhere on the board
-VDC: C2.2, J2.3, J4.3, J6.1, J7.4; also elsewhere on the board
/CH6: J7.6, U4.5 (VOUTC)
/CH7: J7.7, U4.6 (VOUTE)
/CH8: J7.8, U4.7 (VOUTG)
/DINA: U2.6 (2Y), U4.15 (DIN)
/DIND: J3.2, U2.5 (2A)
/SCLKA: R3.2, U2.3 (1Y), U4.16 (SCLK)
/SCLKD: J3.1, U2.2 (1A)
/SYNCA: U2.8 (3Y), U4.2 (~SYNC~)
/SYNCD: J3.4, U2.9 (3A)
/opampdriver/BIAS: C18.1, C19.2, U6.5 (OUTS), U6.6 (OUTF); also elsewhere on the board
/opampdriver/OUT: CH1.T; also elsewhere on the board
/opampdriver/SIG: U4.13 (VOUTB); also elsewhere on the board
/sheet5F77FFF0/OUT: CH2.T; also elsewhere on the board
/sheet5F77FFF0/SIG: U4.12 (VOUTD); also elsewhere on the board
/sheet5F780C4A/OUT: SAMPLE1.T; also elsewhere on the board
/sheet5F780C4A/SIG: U4.4 (VOUTA); also elsewhere on the board
/sheet5F78069E/OUT: CH3.T; also elsewhere on the board
/sheet5F78069E/SIG: U4.11 (VOUTF); also elsewhere on the board
/sheet5FB2767A/OUT: CH4.T; also elsewhere on the board
/sheet5FB2767A/SIG: U4.10 (VOUTH); also elsewhere on the board
GND: C3.2, C4.2, C11.2, J3.5, R4.1, U1.1 (GND), U2.1 (1~OE), U2.4 (2~OE), U2.7 (GND), U2.10 (3~OE), U2.13 (4~OE)
GNDA: C1.2, C2.1, C5.2, C6.1, C7.2, C8.1, C9.2, C10.1, C12.2, C13.2, C14.2, C15.2, C16.2, C17.2, C18.2, C19.1, C40.2, CH1.R, CH1.S, CH2.R, CH2.S, CH3.R, CH3.S, CH4.R, CH4.S, D5.2 (A), D6.1 (K), J1.2, J2.2, J4.2, J7.1, J7.5, R4.2, SAMPLE1.R, SAMPLE1.S, U3.2 (GND), U4.1 (~LDAC~), U4.14 (GND), U5.2 (GND), U6.1 (GNDF), U6.2 (GNDS); also elsewhere on the board
unnamed: C5.1, C7.1, D1.1 (K), D2.1 (K), Q1.2 (C), R1.1
unnamed: C6.2, C8.2, D3.2 (A), D4.2 (A), Q2.2 (C), R2.2
unnamed: C9.1, D5.1 (K), Q1.1 (B), R1.2
unnamed: C10.2, D6.2 (A), Q2.1 (B), R2.1
unnamed: C15.1, C17.1, R5.1, U4.8 (VREFIN/VREFOUT)
unnamed: D1.2 (A), D4.1 (K), J1.3
unnamed: D2.2 (A), D3.1 (K), J1.1
unnamed: J5.1, Q1.3 (E)
unnamed: J6.2, Q2.3 (E)
unnamed: R5.2, U5.5 (OUTF), U5.6 (OUTS)
VCC: C3.1, C4.1, C12.1, C16.1, J3.6, U1.3 (VI), U3.4 (IN), U5.4 (IN)

Notes on the sheet:
Expect total differential < 100V
USE AD5668BRUZ1 for 16 bit, 1.25V internal ref
EXTREFEN
MAX6043a @3.3V
MAX6071a @1.25V
VCC @5V
Ground star node
MAX6043a/b/c @3.3V
RS70D-HM3-08 diodes work well
Negative supply
30V
Positive supply

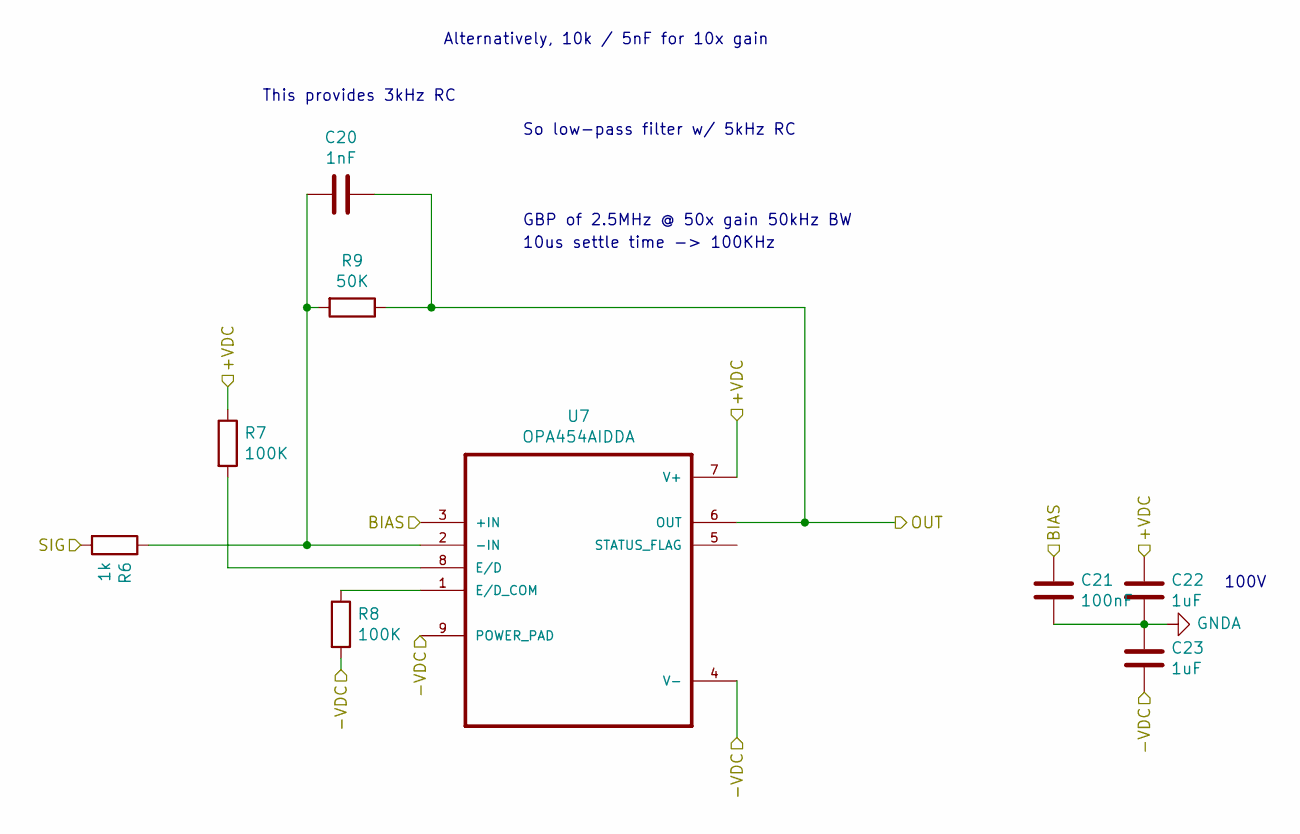
[picture p45: schematic opampdriver.sch]

Parts:
C20: 1nF; C_0805_2012Metric_Pad1.18x1.45mm_HandSolder
C21: 100nF; C_0805_2012Metric_Pad1.18x1.45mm_HandSolder
C22, C23: 1uF; C_0805_2012Metric_Pad1.18x1.45mm_HandSolder
R6: 1k; R_0805_2012Metric_Pad1.20x1.40mm_HandSolder
R7, R8: 100K; R_0805_2012Metric_Pad1.20x1.40mm_HandSolder
R9: 50K; R_0805_2012Metric_Pad1.20x1.40mm_HandSolder
U7: OPA454AIDDA; NOPB

Connections:
+VDC: C22.1, R7.1, U7.7 (V+); also elsewhere on the board
-VDC: C23.2, R8.2, U7.4 (V-), U7.9 (POWER_PAD); also elsewhere on the board
/opampdriver/BIAS: C21.1, U7.3 (+IN); also elsewhere on the board
/opampdriver/OUT: C20.1, R9.1, U7.6 (OUT); also elsewhere on the board
/opampdriver/SIG: R6.2; also elsewhere on the board
GNDA: C21.2, C22.2, C23.1; also elsewhere on the board
unnamed: C20.2, R6.1, R9.2, U7.2 (-IN)
unnamed: R7.2, U7.8 (E/D)
unnamed: R8.1, U7.1 (E/D_COM)

Parts of its further copies:
C24, C28, C32, C36: 1nF; C_0805_2012Metric_Pad1.18x1.45mm_HandSolder
C25, C29, C33, C37: 100nF; C_0805_2012Metric_Pad1.18x1.45mm_HandSolder
C26, C27, C30, C31, C34, C35, C38, C39: 1uF; C_0805_2012Metric_Pad1.18x1.45mm_HandSolder
R10, R14, R18, R22: 1k; R_0805_2012Metric_Pad1.20x1.40mm_HandSolder
R11, R12, R15, R16, R19, R20, R23, R24: 100K; R_0805_2012Metric_Pad1.20x1.40mm_HandSolder
R13, R17, R21, R25: 50K; R_0805_2012Metric_Pad1.20x1.40mm_HandSolder
U8, U9, U10, U11: OPA454AIDDA; NOPB

Connections of its further copies:
+VDC: C26.1, C30.1, C34.1, C38.1, R11.1, R15.1, R19.1, R23.1, U8.7 (V+), U9.7 (V+), U10.7 (V+), U11.7 (V+); also elsewhere on the board
-VDC: C27.2, C31.2, C35.2, C39.2, R12.2, R16.2, R20.2, R24.2, U8.4 (V-), U8.9 (POWER_PAD), U9.4 (V-), U9.9 (POWER_PAD), U10.4 (V-), U10.9 (POWER_PAD), U11.4 (V-), U11.9 (POWER_PAD); also elsewhere on the board
/opampdriver/BIAS: C25.1, C29.1, C33.1, C37.1, U8.3 (+IN), U9.3 (+IN), U10.3 (+IN), U11.3 (+IN); also elsewhere on the board
/sheet5F77FFF0/OUT: C24.1, R13.1, U8.6 (OUT); also elsewhere on the board
/sheet5F77FFF0/SIG: R10.2; also elsewhere on the board
/sheet5F780C4A/OUT: C32.1, R21.1, U10.6 (OUT); also elsewhere on the board
/sheet5F780C4A/SIG: R18.2; also elsewhere on the board
/sheet5F78069E/OUT: C28.1, R17.1, U9.6 (OUT); also elsewhere on the board
/sheet5F78069E/SIG: R14.2; also elsewhere on the board
/sheet5FB2767A/OUT: C36.1, R25.1, U11.6 (OUT); also elsewhere on the board
/sheet5FB2767A/SIG: R22.2; also elsewhere on the board
GNDA: C25.2, C26.2, C27.1, C29.2, C30.2, C31.1, C33.2, C34.2, C35.1, C37.2, C38.2, C39.1; also elsewhere on the board
unnamed: C24.2, R10.1, R13.2, U8.2 (-IN)
unnamed: C28.2, R14.1, R17.2, U9.2 (-IN)
unnamed: C32.2, R18.1, R21.2, U10.2 (-IN)
unnamed: C36.2, R22.1, R25.2, U11.2 (-IN)
unnamed: R11.2, U8.8 (E/D)
unnamed: R12.1, U8.1 (E/D_COM)
unnamed: R15.2, U9.8 (E/D)
unnamed: R16.1, U9.1 (E/D_COM)
unnamed: R19.2, U10.8 (E/D)
unnamed: R20.1, U10.1 (E/D_COM)
unnamed: R23.2, U11.8 (E/D)
unnamed: R24.1, U11.1 (E/D_COM)

Notes on the sheet:
GBP of 2.5MHz @ 50x gain 50kHz BW
10us settle time -> 100KHz
So low-pass filter w/ 5kHz RC
This provides 3kHz RC
Alternatively, 10k / 5nF for 10x gain
100V

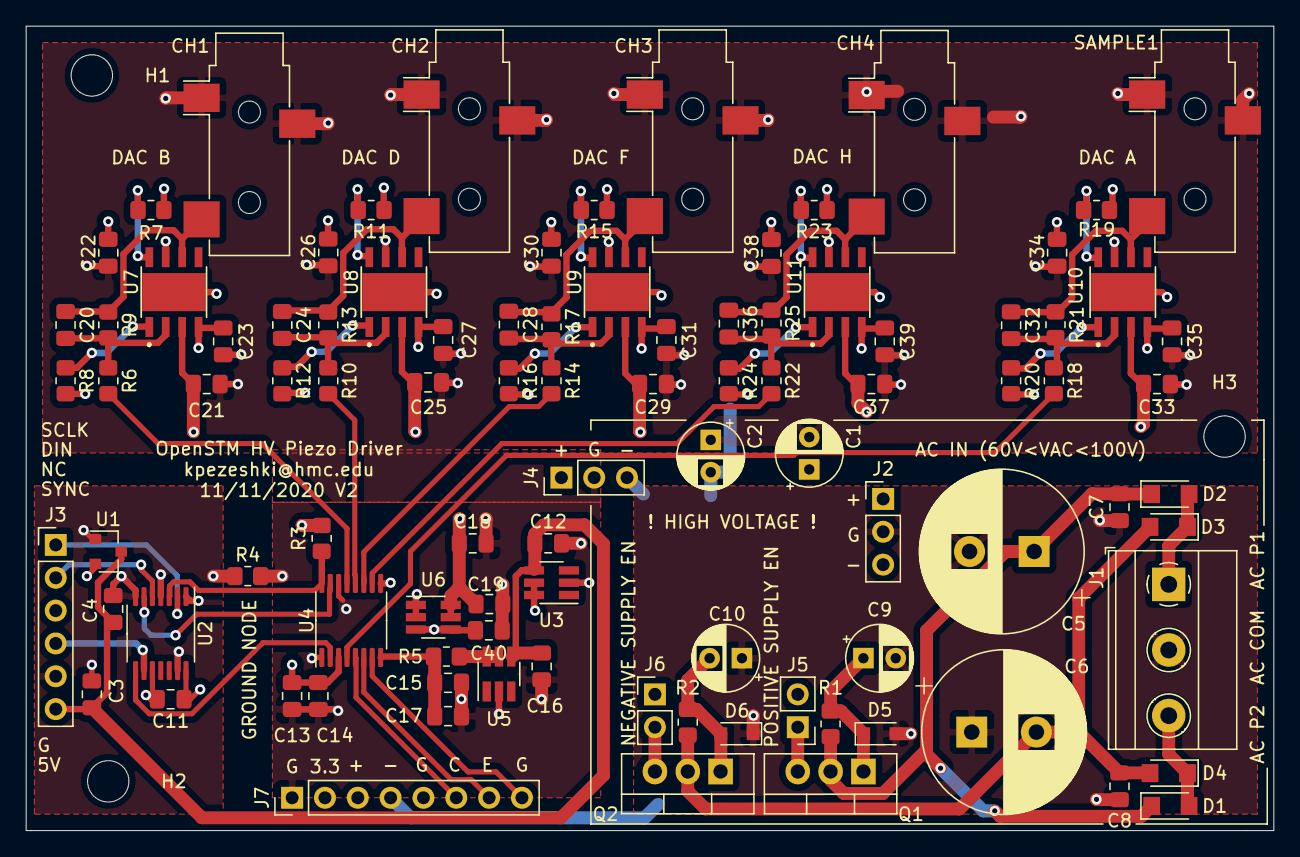
[picture p46: board stm/piezodriverv2/piezodriver.kicad_pcb from above]

Board: 4 copper layers, 96.5 x 62.2 mm, 99 parts (0 on the bottom side), 52 nets.
