Arcturus314/stm_all/stm/highvoltagedriver/highvoltagedriver.kicad_pcb

## KiCad design stm/highvoltagedriver/highvoltagedriver.kicad_pcb (2021-03-22)

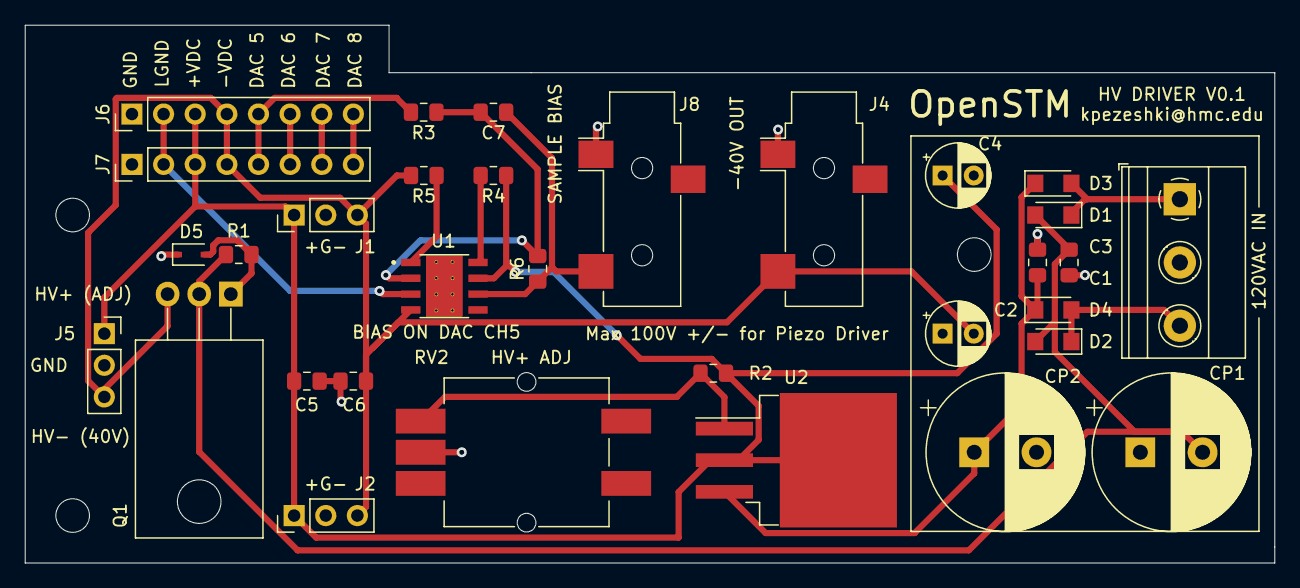
[picture p47: board highvoltagedriver.kicad_pcb from above]

Board: 2 copper layers, 100.3 x 43.2 mm, 32 parts (0 on the bottom side), 18 nets.

Parts:
C1, C3, C5, C6: 1uF; C_0805_2012Metric_Pad1.15x1.40mm_HandSolder
C2, C4: 10uF; CP_Radial_D5.0mm_P2.50mm
C7: 1nF; C_0805_2012Metric_Pad1.15x1.40mm_HandSolder
CP1, CP2: 200uF; CP_Radial_D12.5mm_P5.00mm
D1, D2, D3, D4: D; D_SMF
D5: D_Zener; D_SOD-323
J1, J2: Conn_01x03_Male; PinHeader_1x03_P2.54mm_Vertical
J3: Screw_Terminal_01x03; TerminalBlock_Phoenix_MKDS-1,5-3-5.08_1x03_P5.08mm_Horizont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
J4, J8: AudioJack2; Jack_3.5mm_CUI_SJ-3523-SMT_Horizontal
J5: Conn_01x03_Female; PinSocket_1x03_P2.54mm_Vertical
J6: Conn_01x08_Male; PinHeader_1x08_P2.54mm_Vertical
J7: Conn_01x08_Female; PinHeader_1x08_P2.54mm_Vertical
Q1: TIP127; TO-220-3_Horizontal_TabDown
R1: 10k; R_0805_2012Metric_Pad1.15x1.40mm_HandSolder
R2: 100; R_0805_2012Metric_Pad1.15x1.40mm_HandSolder
R3: 1k; R_0805_2012Metric_Pad1.15x1.40mm_HandSolder
R4, R5: 100K; R_0805_2012Metric_Pad1.15x1.40mm_HandSolder
R6: 50K; R_0805_2012Metric_Pad1.15x1.40mm_HandSolder
RV2: 10k; Potentiometer_Bourns_PRS11S_Vertical
U1: OPA454AIDDA; NOPB
U2: TL783; TO-263-3_TabPin2

Connections:
/DACBIAS: J6.5, J7.5, R3.2
/HVN: C2.2, C6.1, J1.3, J2.3, J4.T, J5.3, J6.4, J7.4, Q1.3, R5.2, U1.4
/HVP: C4.1, C5.1, J1.1, J2.1, J5.1, J6.3, J7.3, R2.2, R4.1, U1.7, U2.2
/biasamp/BIAS: J6.2, J7.2, U1.3
/biasamp/OUT: C7.1, J8.T, R6.1, U1.6
/hvpower/negreg/VNEG: C1.2, CP1.2, D1.2, D2.2, Q1.2, R1.2
GND: C1.1, C2.1, C3.2, C4.2, C5.2, C6.2, CP1.1, CP2.2, D5.1, J1.2, J2.2, J3.2, J4.S, J5.2, J6.1, J7.1, J8.S, RV2.2
unnamed: C3.1, CP2.1, D3.1, D4.1, U2.3
unnamed: C7.2, R3.1, R6.2, U1.2
unnamed: D1.1, D3.2, J3.1
unnamed: D2.1, D4.2, J3.3
unnamed: D5.2, Q1.1, R1.1
unnamed: J6.6, J7.6
unnamed: J6.7, J7.7
unnamed: J6.8, J7.8
unnamed: R2.1, RV2.1, U2.1
unnamed: R4.2, U1.8
unnamed: R5.1, U1.1
