Arcturus314/stm_all/stm/piezobreakout/piezobreakout.kicad_pcb

## KiCad design stm/piezobreakout/piezobreakout.kicad_pcb (2021-03-22)

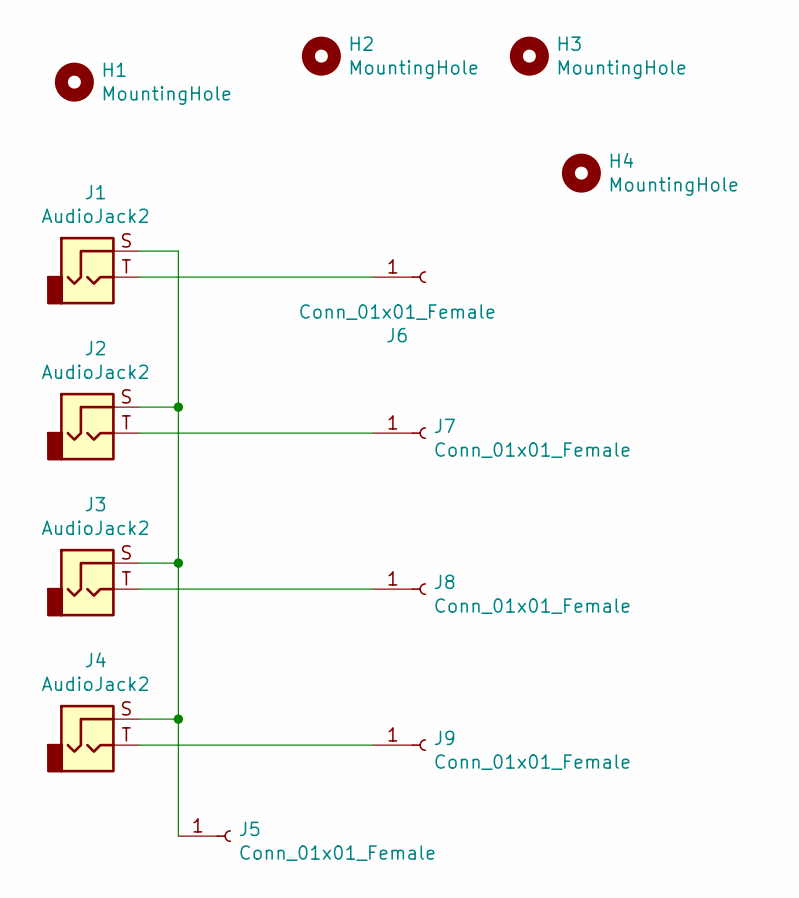
[picture p48: schematic piezobreakout.sch]

Parts:
H1, H2, H3, H4: MountingHole; MountingHole_3.2mm_M3
J1, J2, J3, J4: AudioJack2; Jack_3.5mm_CUI_SJ-3523-SMT_Horizontal
J5, J6, J7, J8, J9: Conn_01x01_Female; PinHeader_1x01_P2.54mm_Vertical

Connections:
unnamed: J1.S, J2.S, J3.S, J4.S, J5.1
unnamed: J1.T, J6.1
unnamed: J2.T, J7.1
unnamed: J3.T, J8.1
unnamed: J4.T, J9.1

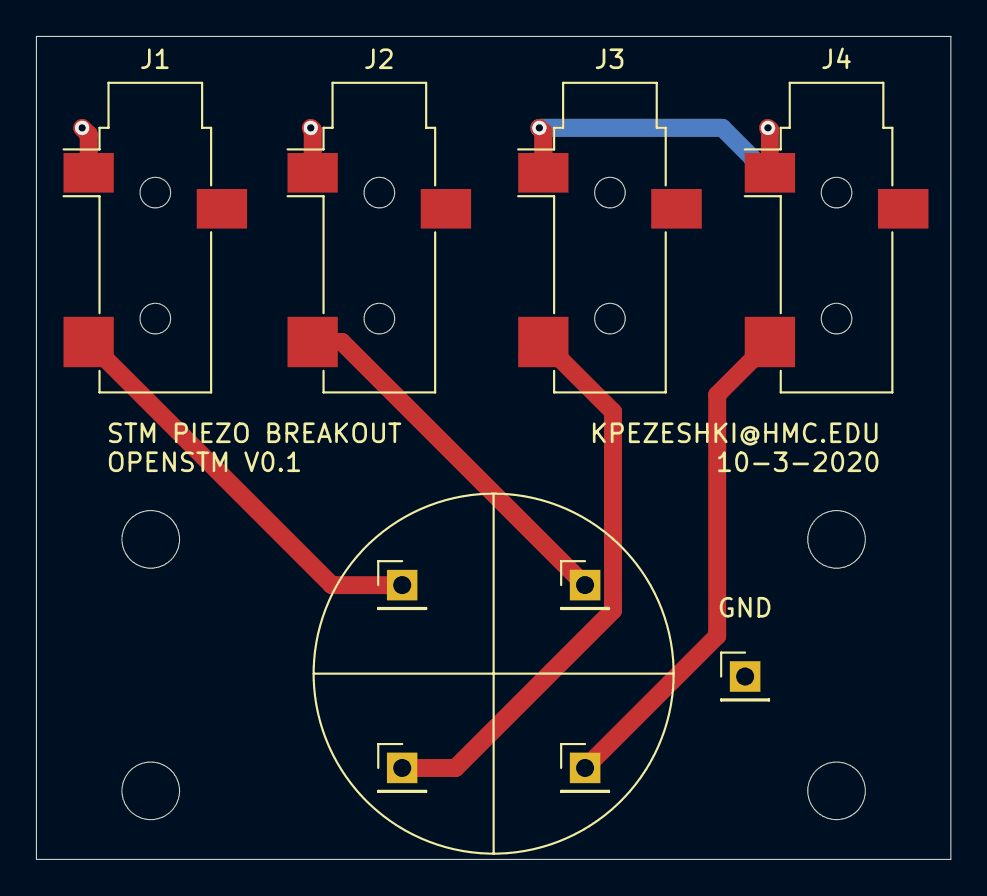
[picture p49: board piezobreakout.kicad_pcb from above]

Board: 2 copper layers, 50.8 x 45.7 mm, 13 parts (0 on the bottom side), 5 nets.
