Arcturus314/stm_all/stm/frontendamp/frontendfull/frontendfull.kicad_pcb

## KiCad design stm/frontendamp/frontendfull/frontendfull.kicad_pcb (2021-03-22)

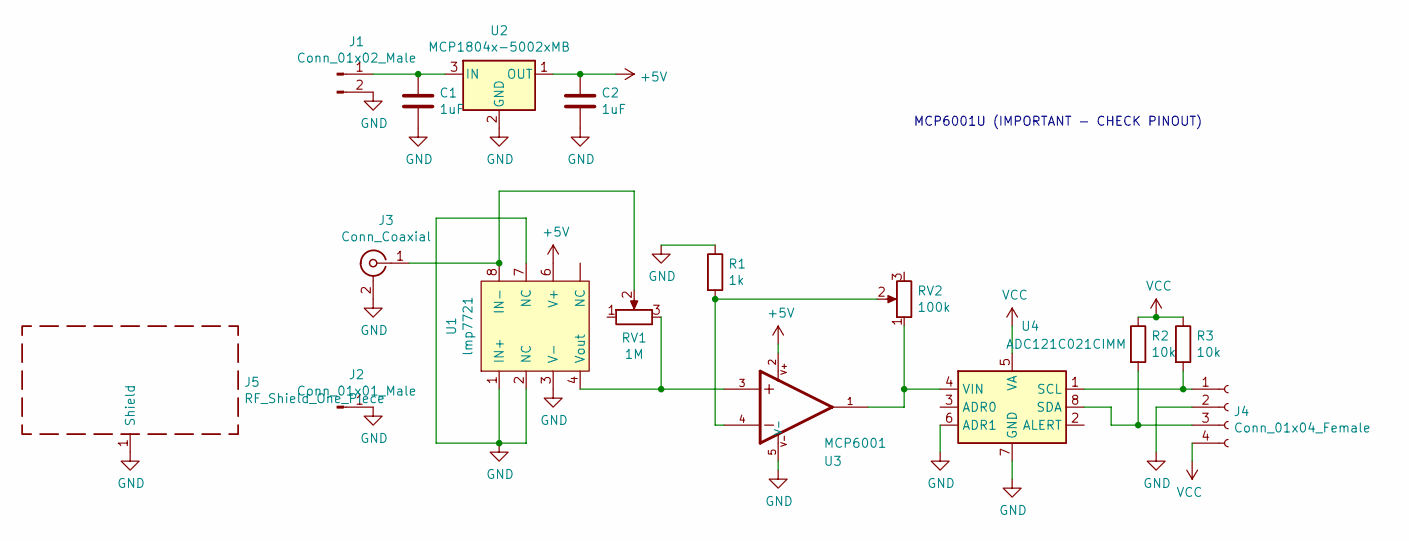
[picture p50: schematic frontendfull.sch]

Parts:
C1, C2: 1uF; C_0805_2012Metric_Pad1.15x1.40mm_HandSolder
J1: Conn_01x02_Male; PinSocket_1x02_P2.54mm_Vertical
J2: Conn_01x01_Male; PinSocket_1x01_P2.54mm_Vertical
J3: Conn_Coaxial; U.FL_Hirose_U.FL-R-SMT-1_Vertical
J4: Conn_01x04_Female; PinHeader_1x04_P2.54mm_Vertical
J5: RF_Shield_One_Piece; Laird_Technologies_BMI-S-202-F_16.50x16.50mm
R1: 1k; R_0805_2012Metric_Pad1.15x1.40mm_HandSolder
R2, R3: 10k; R_0805_2012Metric_Pad1.15x1.40mm_HandSolder
RV1: 1M; Potentiometer_Bourns_3314J_Vertical
RV2: 100k; Potentiometer_Bourns_3314J_Vertical
U1: lmp7721
U2: MCP1804x-5002xMB; SOT-89-3
U3: MCP6001; SOT-23-5_HandSoldering
U4: ADC121C021CIMM; MSOP-8_3x3mm_P0.65mm

Connections:
+5V: C2.1, U1.6 (V+), U2.1 (OUT), U3.2
GND: C1.2, C2.2, J1.2, J2.1, J3.2 (Ext), J4.2, J5.1, R1.1, U1.1 (IN+), U1.2 (NC), U1.3 (V-), U1.7 (NC), U2.2 (GND), U3.5 (V-), U4.6 (ADR1), U4.7 (GND)
unnamed: C1.1, J1.1, U2.3 (IN)
unnamed: J3.1 (In), RV1.2, U1.8 (IN-)
unnamed: J4.1, R3.2, U4.1 (SCL)
unnamed: J4.3, R2.2, U4.8 (SDA)
unnamed: R1.2, RV2.2, U3.4
unnamed: RV1.3, U1.4 (Vout), U3.3
unnamed: RV2.1, U3.1, U4.4 (VIN)
VCC: J4.4, R2.1, R3.1, U4.5 (VA)

Notes on the sheet:
MCP6001U (IMPORTANT - CHECK PINOUT)

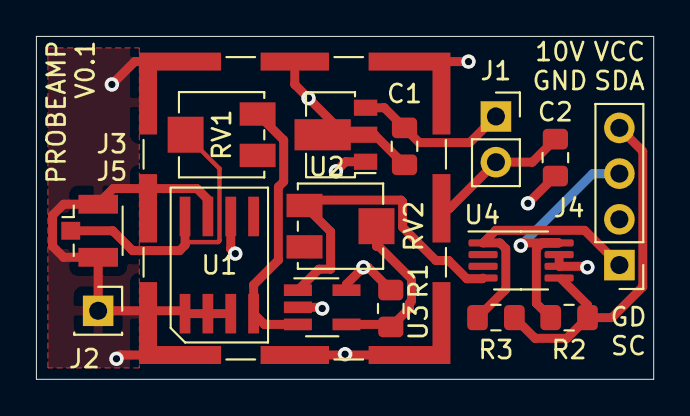
[picture p51: board frontendfull.kicad_pcb from above]

Board: 4 copper layers, 34.3 x 19.0 mm, 16 parts (0 on the bottom side), 10 nets.
