Arcturus314/stm_all/stm/samplepad/samplepad/samplepad.kicad_pcb

## KiCad design stm/samplepad/samplepad/samplepad.kicad_pcb (2021-03-22)

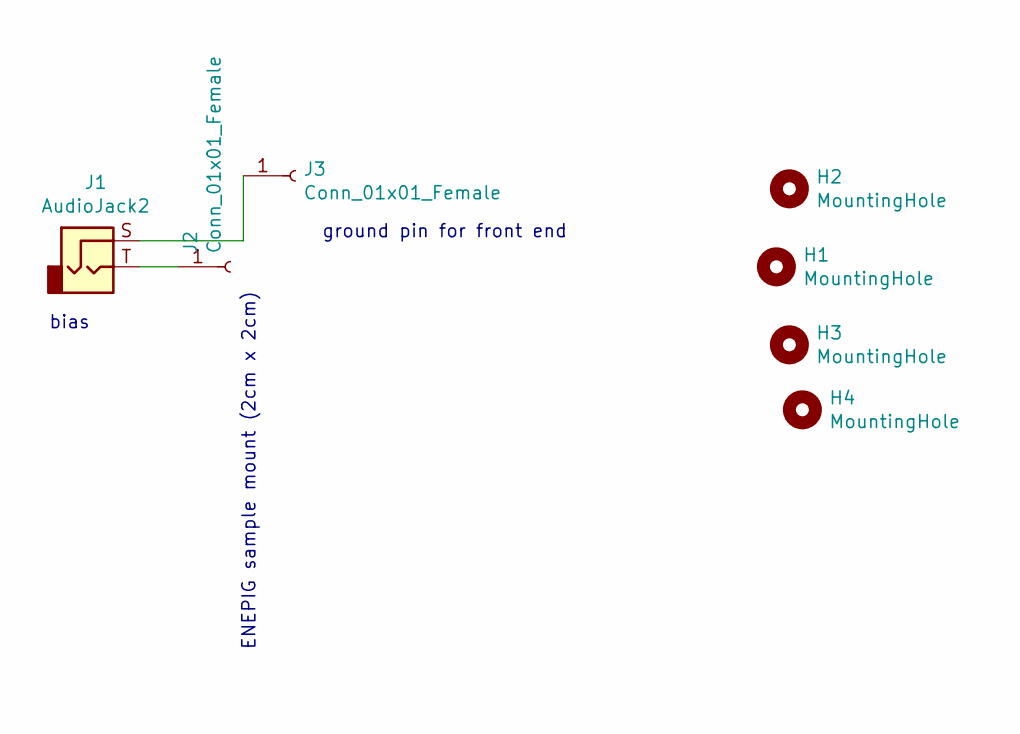
[picture p52: schematic samplepad.sch]

Parts:
H1, H2, H3, H4: MountingHole; MountingHole_2.2mm_M2
J1: AudioJack2; Jack_3.5mm_CUI_SJ-3523-SMT_Horizontal
J2: Conn_01x01_Female; mountingpad
J3: Conn_01x01_Female; PinHeader_1x01_P2.54mm_Vertical

Connections:
unnamed: J1.S, J3.1
unnamed: J1.T, J2.1

Notes on the sheet:
ENEPIG sample mount (2cm x 2cm)
ground pin for front end
bias

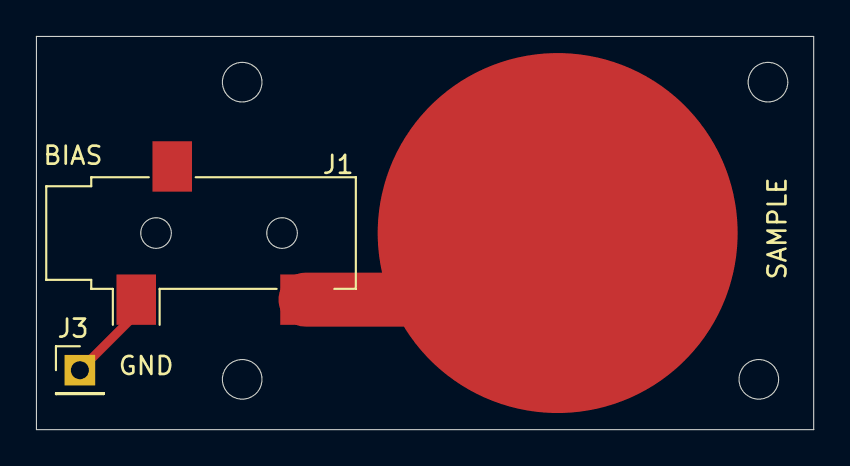
[picture p53: board samplepad.kicad_pcb from above]

Board: 2 copper layers, 43.2 x 21.8 mm, 7 parts (0 on the bottom side), 2 nets.
