Arcturus314/stm_all/analogfrontend/analogfrontend.kicad_pcb

## KiCad design analogfrontend/analogfrontend.kicad_pcb (2021-03-22)

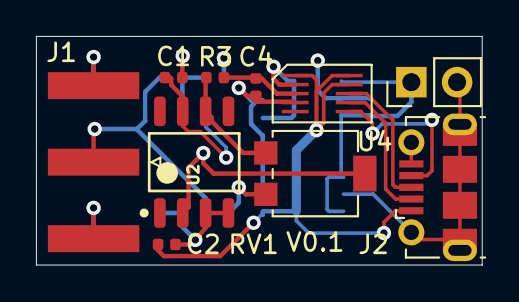
[picture p54: board analogfrontend.kicad_pcb from above]

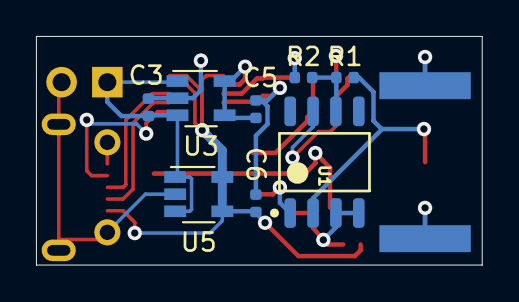
[picture p55: board analogfrontend.kicad_pcb from below]

Board: 4 copper layers, 24.8 x 12.7 mm, 18 parts (8 on the bottom side), 12 nets.

Parts:
C1, C2: 100nF; C_0402_1005Metric
C3: 4.7uF; C_0402_1005Metric
C4: 2nF; C_0402_1005Metric
C5, C6: 2.2uF; C_0402_1005Metric
J1: Conn_Coaxial; SMA_Amphenol_132289_EdgeMount
J2: USB_OTG; USB_Micro-B_Molex-105017-0001
J3: Conn_01x02_Male; PinHeader_1x02_P2.54mm_Vertical
R1: 1M; R_0402_1005Metric
R2: 100; R_0402_1005Metric
R3: 22; R_0402_1005Metric
RV1: 10k; Potentiometer_Bourns_3314G_Vertical
U1, U2: OPA124UA; Texas_Instruments-OPA124UA-Level_A
U3: ADP7142AUJZ-1.8; TSOT-23-5
U4: MCP33131
U5: ADP7142AUJZ-3.3; TSOT-23-5

Connections:
+1V8: C5.1, U3.4, U3.5, U4.2
+3V3: C1.1, C2.1, C6.1, J2.1, U1.7, U2.7, U4.1, U4.9, U4.10, U5.4, U5.5
+5V: C3.1, J3.1, U3.1, U3.3, U5.1, U5.3
GND: C1.2, C2.2, C3.2, C4.2, C5.2, C6.2, J1.2, J2.5, J2.6, J3.2, U1.3, U1.4, U2.3, U2.4, U3.2, U4.4, U5.2
unnamed: C4.1, R3.1, U4.3
unnamed: J1.1, R1.2, U1.2
unnamed: J2.2, U4.7
unnamed: J2.3, U4.8
unnamed: J2.4, U4.6
unnamed: R1.1, R2.2, U1.6
unnamed: R2.1, RV1.2, U2.2
unnamed: R3.2, RV1.1, U2.6
