Arcturus314/stm_all/stm/frontendamp/frontendfullv2/frontendfullv2/frontendfull_lm7721/frontendfullv2.kicad_pcb

## KiCad design stm/frontendamp/frontendfullv2/frontendfullv2/frontendfull_lm7721/frontendfullv2.kicad_pcb (2021-03-22)

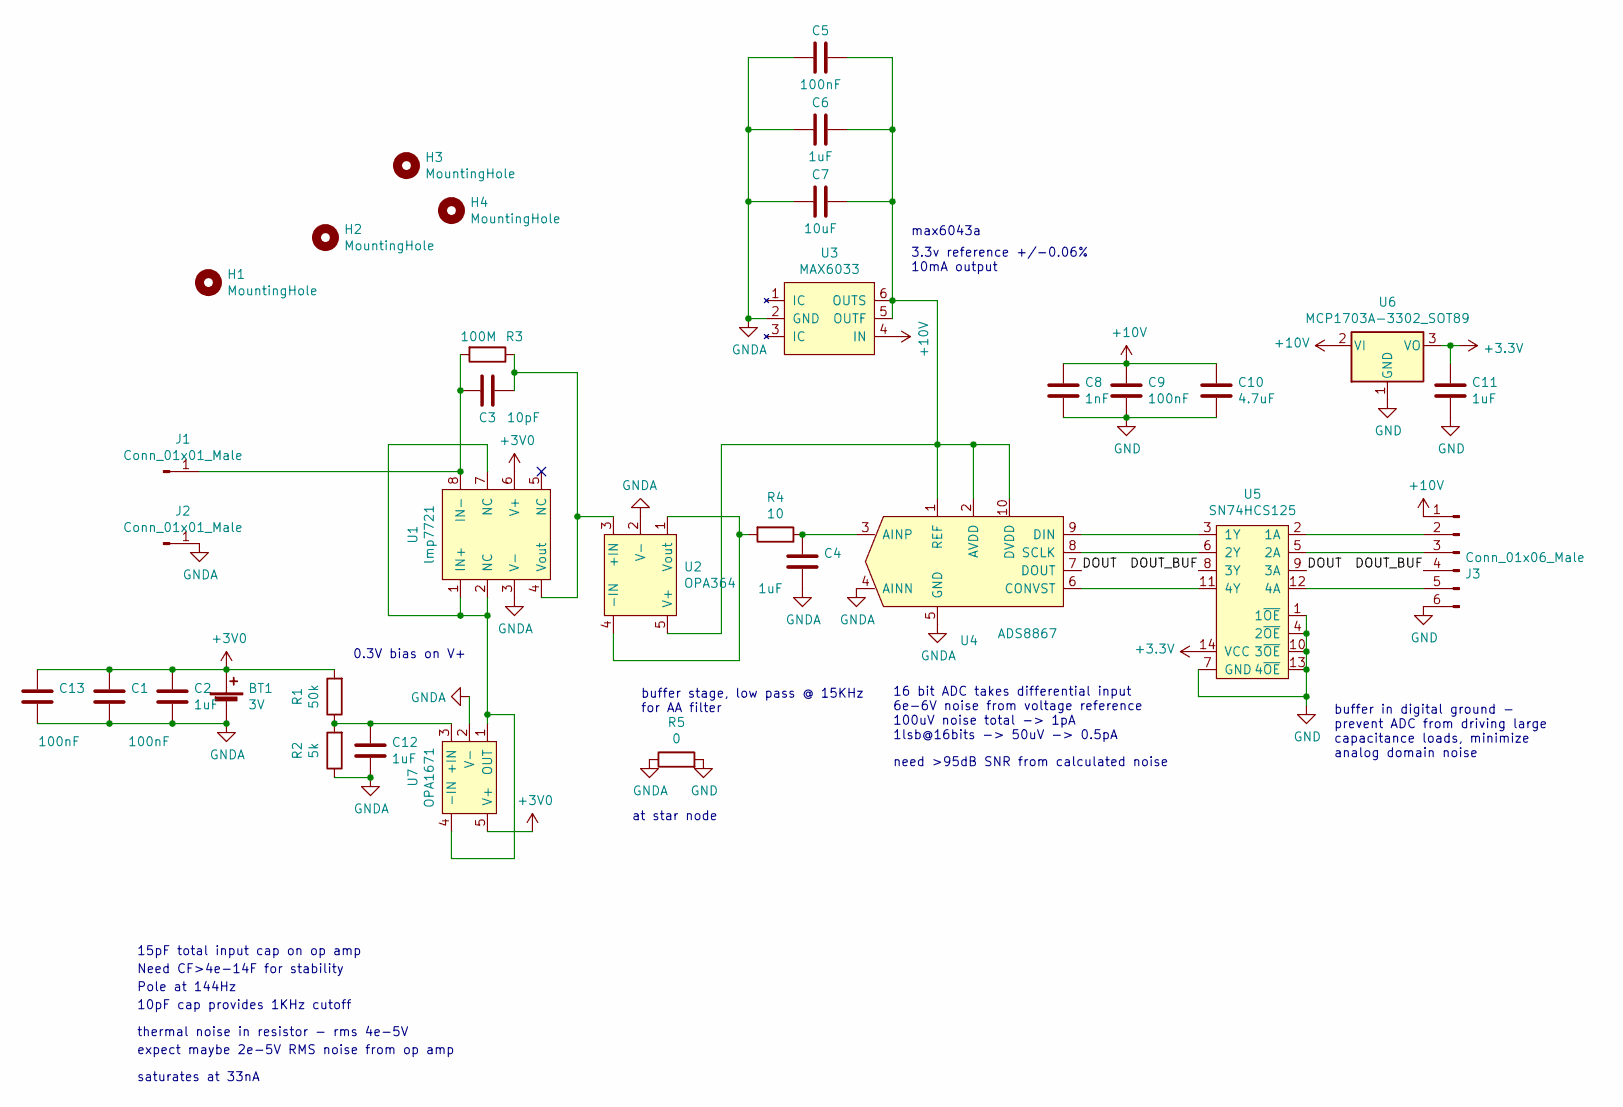
[picture p56: schematic frontendfullv2.sch]

Parts:
BT1: 3V; BatteryHolder_Keystone_1058_1x2032
C1, C5, C9: 100nF; C_0603_1608Metric_Pad1.08x0.95mm_HandSolder
C2, C4, C6, C11: 1uF; C_0603_1608Metric_Pad1.08x0.95mm_HandSolder
C3: 10pF; C_0805_2012Metric_Pad1.15x1.40mm_HandSolder
C7: 10uF; C_0805_2012Metric_Pad1.15x1.40mm_HandSolder
C8: 1nF; C_0603_1608Metric_Pad1.08x0.95mm_HandSolder
C10: 4.7uF; C_0603_1608Metric_Pad1.08x0.95mm_HandSolder
C12: 1uF; C_0603_1608Metric_Pad1.05x0.95mm_HandSolder
C13: 100nF; C_0603_1608Metric_Pad1.05x0.95mm_HandSolder
H1, H2, H3, H4: MountingHole; MountingHole_2.2mm_M2
J1: Conn_01x01_Male; smallpad
J2: Conn_01x01_Male; PinHeader_1x01_P2.54mm_Vertical
J3: Conn_01x06_Male; PinSocket_1x06_P2.54mm_Vertical
R1: 50k; R_0603_1608Metric_Pad0.98x0.95mm_HandSolder
R2: 5k; R_0603_1608Metric_Pad0.98x0.95mm_HandSolder
R3: 100M; R_0805_2012Metric
R4: 10; R_0603_1608Metric_Pad0.98x0.95mm_HandSolder
R5: 0; R_0603_1608Metric_Pad0.98x0.95mm_HandSolder
U1: lmp7721
U2: OPA364; SOT-23-5_HandSoldering
U3: MAX6033; SOT-23-6_Handsoldering
U4: ADS8867; VSSOP-10_3x3mm_P0.5mm
U5: SN74HCS125; TSSOP-14_4.4x5mm_P0.65mm
U6: MCP1703A-3302_SOT89; SOT-89-3
U7: OPA1671; SOT-23-5_HandSoldering

Connections:
+3V0: BT1.1 (+), C1.1, C2.1, C13.1, R1.2, U1.6 (V+), U7.5 (V+)
+3V3: C11.1, U5.14 (VCC), U6.3 (VO)
+10V: C8.1, C9.1, C10.1, J3.1, U3.4 (IN), U6.2 (VI)
/DOUT: U4.7 (DOUT), U5.9 (3A)
/DOUT_BUF: J3.4, U5.8 (3Y)
GND: C8.2, C9.2, C10.2, C11.2, J3.6, R5.2, U5.1 (1~OE), U5.4 (2~OE), U5.7 (GND), U5.10 (3~OE), U5.13 (4~OE), U6.1 (GND)
GNDA: BT1.2 (-), C1.2, C2.2, C4.2, C5.2, C6.2, C7.2, C12.2, C13.2, J2.1, R2.1, R5.1, U1.3 (V-), U2.2 (V-), U3.2 (GND), U4.4 (AINN), U4.5 (GND), U7.2 (V-)
unnamed: C3.1, J1.1, R3.2, U1.8 (IN-)
unnamed: C3.2, R3.1, U1.4 (Vout), U2.3 (+IN)
unnamed: C4.1, R4.1, U4.3 (AINP)
unnamed: C5.1, C6.1, C7.1, U2.5 (V+), U3.5 (OUTF), U3.6 (OUTS), U4.1 (REF), U4.2 (AVDD), U4.10 (DVDD)
unnamed: C12.1, R1.1, R2.2, U7.3 (+IN)
unnamed: J3.2, U5.2 (1A)
unnamed: J3.3, U5.5 (2A)
unnamed: J3.5, U5.12 (4A)
unnamed: R4.2, U2.1 (Vout), U2.4 (-IN)
unnamed: U1.1 (IN+), U1.2 (NC), U1.7 (NC), U7.1 (OUT), U7.4 (-IN)
unnamed: U4.6 (CONVST), U5.11 (4Y)
unnamed: U4.8 (SCLK), U5.6 (2Y)
unnamed: U4.9 (DIN), U5.3 (1Y)

Notes on the sheet:
16 bit ADC takes differential input 6e-6V noise from voltage reference 100uV noise total -> 1pA 1lsb@16bits -> 50uV -> 0.5pA
max6043a
3.3v reference +/-0.06% 10mA output
0.3V bias on V+
thermal noise in resistor - rms 4e-5V
10pF cap provides 1KHz cutoff
Pole at 144Hz
Need CF>4e-14F for stability
15pF total input cap on op amp
buffer stage, low pass @ 15KHz for AA filter
expect maybe 2e-5V RMS noise from op amp
need >95dB SNR from calculated noise
buffer in digital ground - prevent ADC from driving large capacitance loads, minimize analog domain noise
at star node
saturates at 33nA

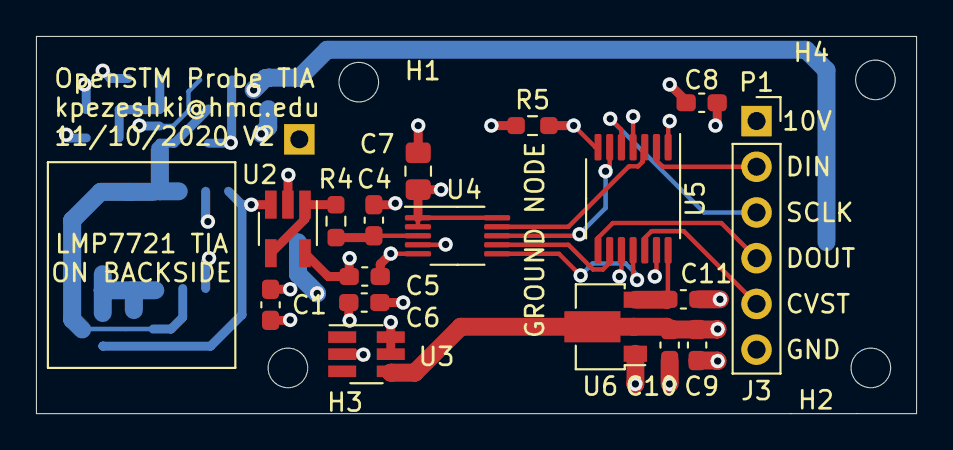
[picture p57: board frontendfullv2.kicad_pcb from above]

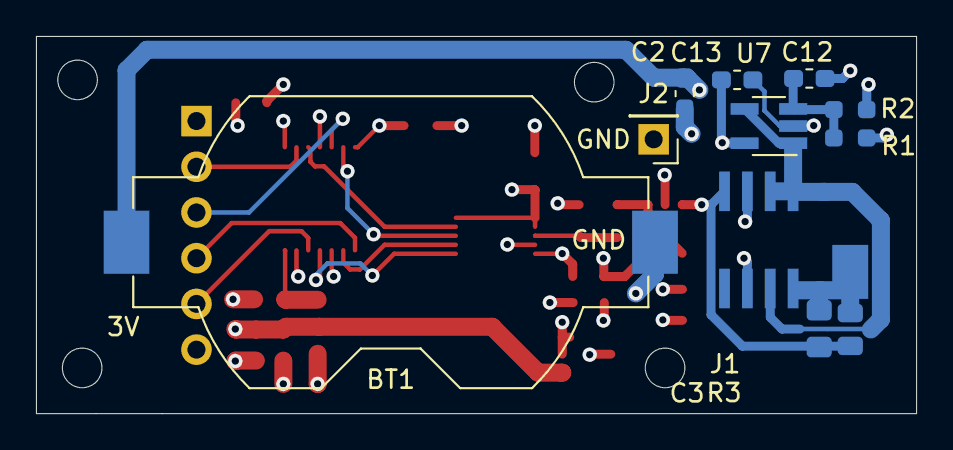
[picture p58: board frontendfullv2.kicad_pcb from below]

Board: 4 copper layers, 48.9 x 21.0 mm, 33 parts (12 on the bottom side), 20 nets.
