Arcturus314/stm_all/stm/frontendamp/frontendtest/frontendtest.kicad_pcb

## KiCad design stm/frontendamp/frontendtest/frontendtest.kicad_pcb (2021-03-22)

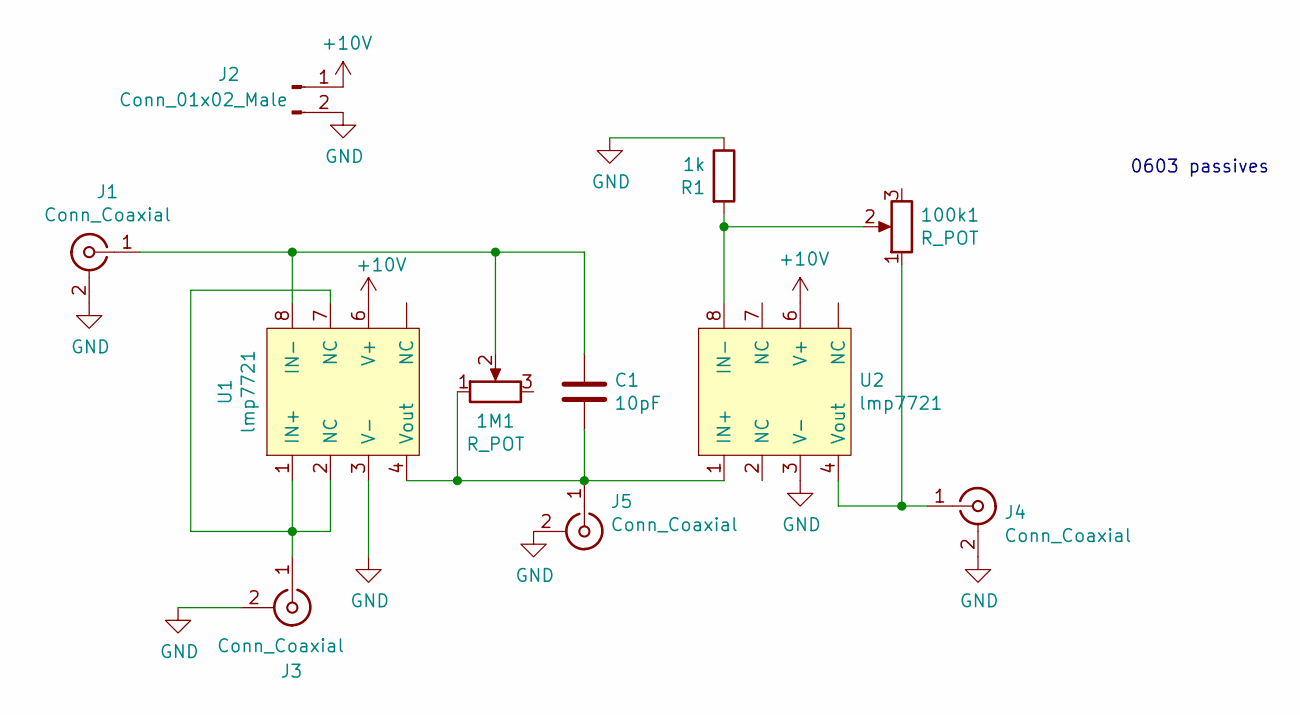
[picture p59: schematic frontendtest.sch]

Parts:
1M1, 100k1: R_POT; Potentiometer_Bourns_3314J_Vertical
C1: 10pF; C_0603_1608Metric
J1, J3, J4, J5: Conn_Coaxial; SMA_Amphenol_132134_Vertical
J2: Conn_01x02_Male; PinHeader_1x02_P2.54mm_Vertical
R1: 1k; R_0603_1608Metric
U1, U2: lmp7721

Connections:
+10V: J2.1, U1.6 (V+), U2.6 (V+)
GND: J1.2 (Ext), J2.2, J3.2 (Ext), J4.2 (Ext), J5.2 (Ext), R1.1, U1.3 (V-), U2.3 (V-)
unnamed: 1M1.1, C1.2, J5.1 (In), U1.4 (Vout), U2.1 (IN+)
unnamed: 1M1.2, C1.1, J1.1 (In), U1.8 (IN-)
unnamed: 100k1.1, J4.1 (In), U2.4 (Vout)
unnamed: 100k1.2, R1.2, U2.8 (IN-)
unnamed: J3.1 (In), U1.1 (IN+), U1.2 (NC), U1.7 (NC)

Notes on the sheet:
0603 passives

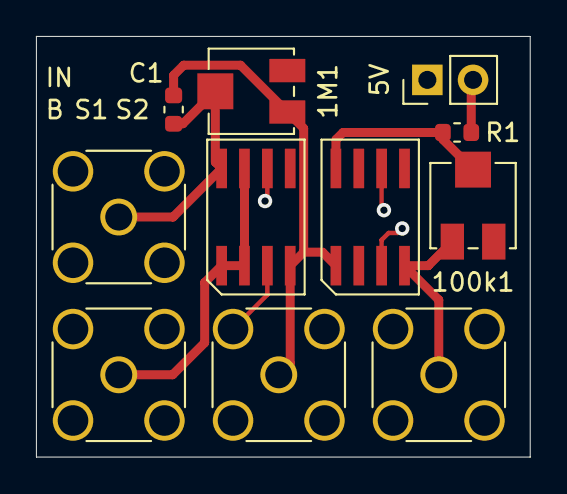
[picture p60: board frontendtest.kicad_pcb from above]

Board: 4 copper layers, 27.4 x 23.4 mm, 11 parts (0 on the bottom side), 7 nets.
