Arcturus314/stm_all/stm/piezodriver/piezodriver.kicad_pcb

## KiCad design stm/piezodriver/piezodriver.kicad_pcb (2021-03-22)

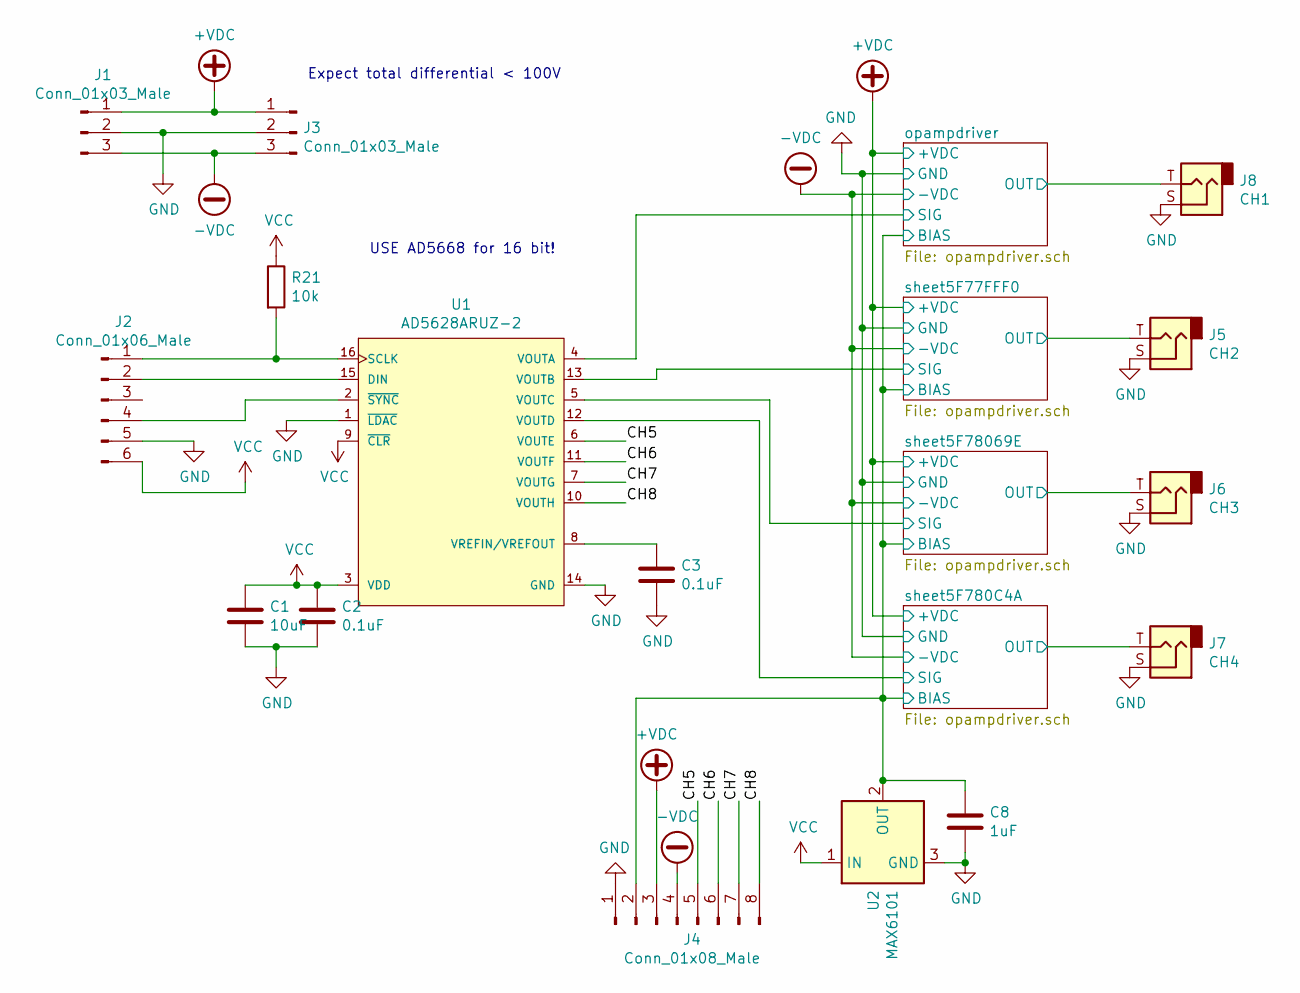
[picture p61: schematic piezodriver.sch]

Parts:
C1: 10uF; C_0805_2012Metric_Pad1.15x1.40mm_HandSolder
C2, C3: 0.1uF; C_0805_2012Metric_Pad1.15x1.40mm_HandSolder
C8: 1uF; C_0805_2012Metric_Pad1.15x1.40mm_HandSolder
J1, J3: Conn_01x03_Male; PinHeader_1x03_P2.54mm_Vertical
J2: Conn_01x06_Male; PinHeader_1x06_P2.54mm_Vertical
J4: Conn_01x08_Male; PinHeader_1x08_P2.54mm_Vertical
J5: CH2; Jack_3.5mm_CUI_SJ-3523-SMT_Horizontal
J6: CH3; Jack_3.5mm_CUI_SJ-3523-SMT_Horizontal
J7: CH4; Jack_3.5mm_CUI_SJ-3523-SMT_Horizontal
J8: CH1; Jack_3.5mm_CUI_SJ-3523-SMT_Horizontal
R21: 10k; R_0805_2012Metric_Pad1.15x1.40mm_HandSolder
U1: AD5628ARUZ-2; TSSOP-16_4.4x5mm_P0.65mm
U2: MAX6101; SOT-23

Connections:
+VDC: J1.1, J3.1, J4.3; also elsewhere on the board
-VDC: J1.3, J3.3, J4.4; also elsewhere on the board
/CH5: J4.5, U1.6 (VOUTE)
/CH6: J4.6, U1.11 (VOUTF)
/CH7: J4.7, U1.7 (VOUTG)
/CH8: J4.8, U1.10 (VOUTH)
/opampdriver/BIAS: C8.1, J4.2, U2.2 (OUT); also elsewhere on the board
/opampdriver/OUT: J8.T; also elsewhere on the board
/opampdriver/SIG: U1.4 (VOUTA); also elsewhere on the board
/sheet5F77FFF0/OUT: J5.T; also elsewhere on the board
/sheet5F77FFF0/SIG: U1.13 (VOUTB); also elsewhere on the board
/sheet5F780C4A/OUT: J7.T; also elsewhere on the board
/sheet5F780C4A/SIG: U1.12 (VOUTD); also elsewhere on the board
/sheet5F78069E/OUT: J6.T; also elsewhere on the board
/sheet5F78069E/SIG: U1.5 (VOUTC); also elsewhere on the board
GND: C1.2, C2.2, C3.2, C8.2, J1.2, J2.5, J3.2, J4.1, J5.S, J6.S, J7.S, J8.S, U1.1 (~LDAC~), U1.14 (GND), U2.3 (GND)
unnamed: C3.1, U1.8 (VREFIN/VREFOUT)
unnamed: J2.1, R21.2, U1.16 (SCLK)
unnamed: J2.2, U1.15 (DIN)
unnamed: J2.4, U1.2 (~SYNC~)
VCC: C1.1, C2.1, J2.6, R21.1, U1.3 (VDD), U1.9 (~CLR~), U2.1 (IN)

Notes on the sheet:
Expect total differential < 100V
USE AD5668 for 16 bit!

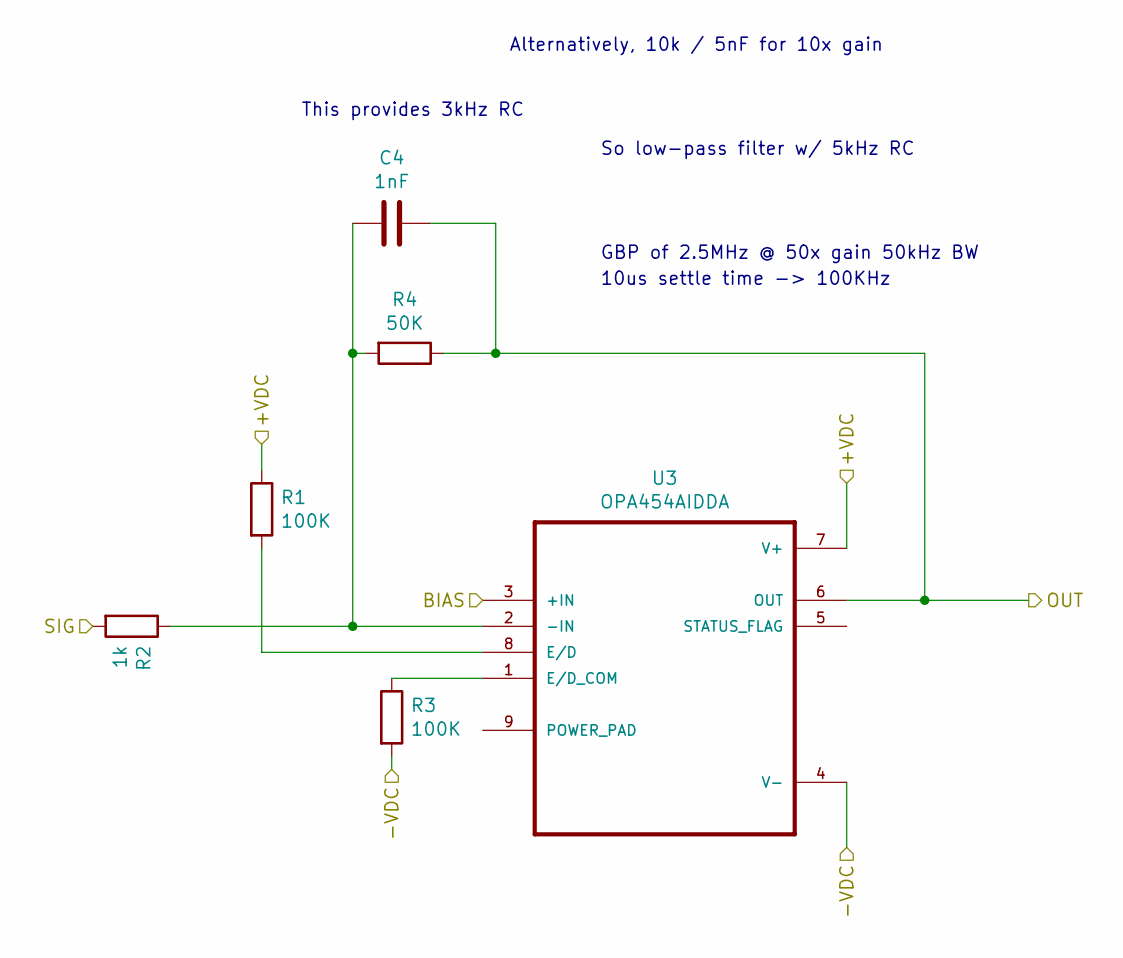
[picture p62: schematic opampdriver.sch]

Parts:
C4: 1nF; C_0805_2012Metric_Pad1.15x1.40mm_HandSolder
R1, R3: 100K; R_0805_2012Metric_Pad1.15x1.40mm_HandSolder
R2: 1k; R_0805_2012Metric_Pad1.15x1.40mm_HandSolder
R4: 50K; R_0805_2012Metric_Pad1.15x1.40mm_HandSolder
U3: OPA454AIDDA; NOPB

Connections:
+VDC: R1.1, U3.7 (V+); also elsewhere on the board
-VDC: R3.2, U3.4 (V-); also elsewhere on the board
/opampdriver/BIAS: U3.3 (+IN); also elsewhere on the board
/opampdriver/OUT: C4.1, R4.1, U3.6 (OUT); also elsewhere on the board
/opampdriver/SIG: R2.2; also elsewhere on the board
unnamed: C4.2, R2.1, R4.2, U3.2 (-IN)
unnamed: R1.2, U3.8 (E/D)
unnamed: R3.1, U3.1 (E/D_COM)

Parts of its further copies:
C5, C6, C7: 1nF; C_0805_2012Metric_Pad1.15x1.40mm_HandSolder
R6, R8, R11, R13, R16, R18: 100K; R_0805_2012Metric_Pad1.15x1.40mm_HandSolder
R7, R12, R17: 1k; R_0805_2012Metric_Pad1.15x1.40mm_HandSolder
R9, R14, R19: 50K; R_0805_2012Metric_Pad1.15x1.40mm_HandSolder
U4, U5, U6: OPA454AIDDA; NOPB

Connections of its further copies:
+VDC: R6.1, R11.1, R16.1, U4.7 (V+), U5.7 (V+), U6.7 (V+); also elsewhere on the board
-VDC: R8.2, R13.2, R18.2, U4.4 (V-), U5.4 (V-), U6.4 (V-); also elsewhere on the board
/opampdriver/BIAS: U4.3 (+IN), U5.3 (+IN), U6.3 (+IN); also elsewhere on the board
/sheet5F77FFF0/OUT: C5.1, R9.1, U4.6 (OUT); also elsewhere on the board
/sheet5F77FFF0/SIG: R7.2; also elsewhere on the board
/sheet5F780C4A/OUT: C7.1, R19.1, U6.6 (OUT); also elsewhere on the board
/sheet5F780C4A/SIG: R17.2; also elsewhere on the board
/sheet5F78069E/OUT: C6.1, R14.1, U5.6 (OUT); also elsewhere on the board
/sheet5F78069E/SIG: R12.2; also elsewhere on the board
unnamed: C5.2, R7.1, R9.2, U4.2 (-IN)
unnamed: C6.2, R12.1, R14.2, U5.2 (-IN)
unnamed: C7.2, R17.1, R19.2, U6.2 (-IN)
unnamed: R6.2, U4.8 (E/D)
unnamed: R8.1, U4.1 (E/D_COM)
unnamed: R11.2, U5.8 (E/D)
unnamed: R13.1, U5.1 (E/D_COM)
unnamed: R16.2, U6.8 (E/D)
unnamed: R18.1, U6.1 (E/D_COM)

Notes on the sheet:
GBP of 2.5MHz @ 50x gain 50kHz BW
10us settle time -> 100KHz
So low-pass filter w/ 5kHz RC
This provides 3kHz RC
Alternatively, 10k / 5nF for 10x gain

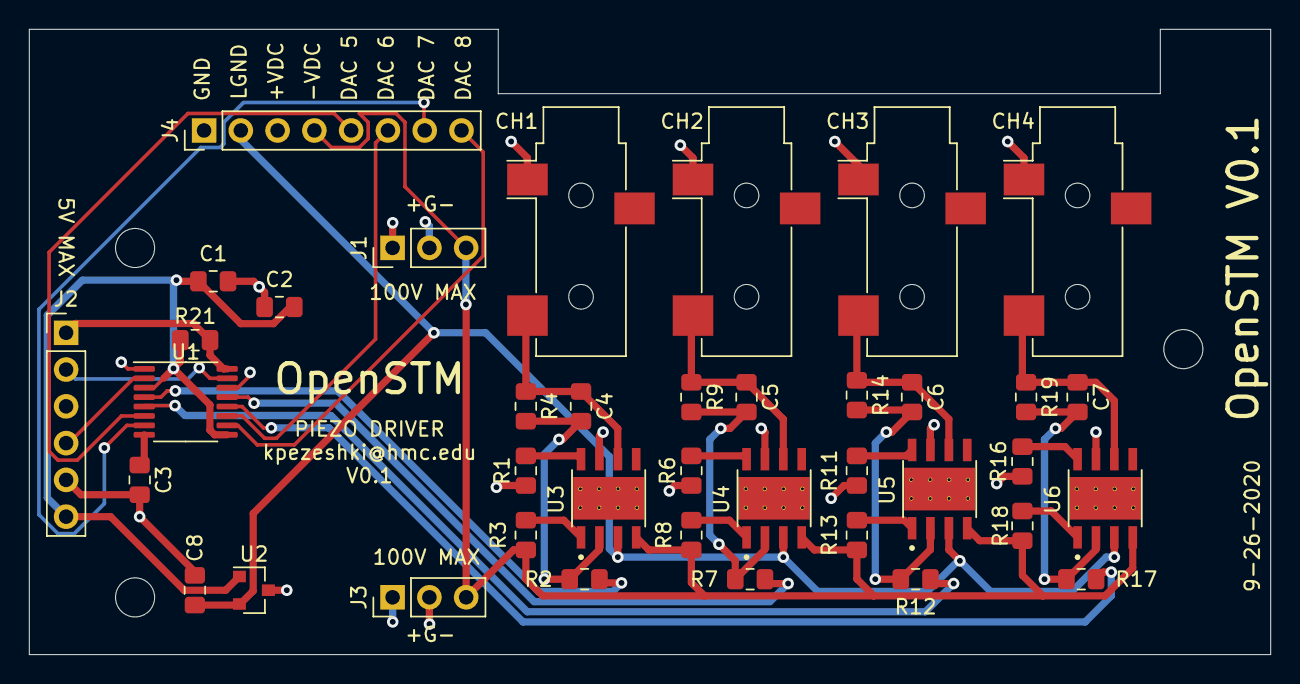
[picture p63: board stm/piezodriver/piezodriver.kicad_pcb from above]

Board: 4 copper layers, 85.7 x 43.2 mm, 39 parts (0 on the bottom side), 33 nets.
