Arcturus314/stm_all/stm/userinterfacepcb/userinterfacepcb.kicad_pcb

## KiCad design stm/userinterfacepcb/userinterfacepcb.kicad_pcb (2021-03-22)

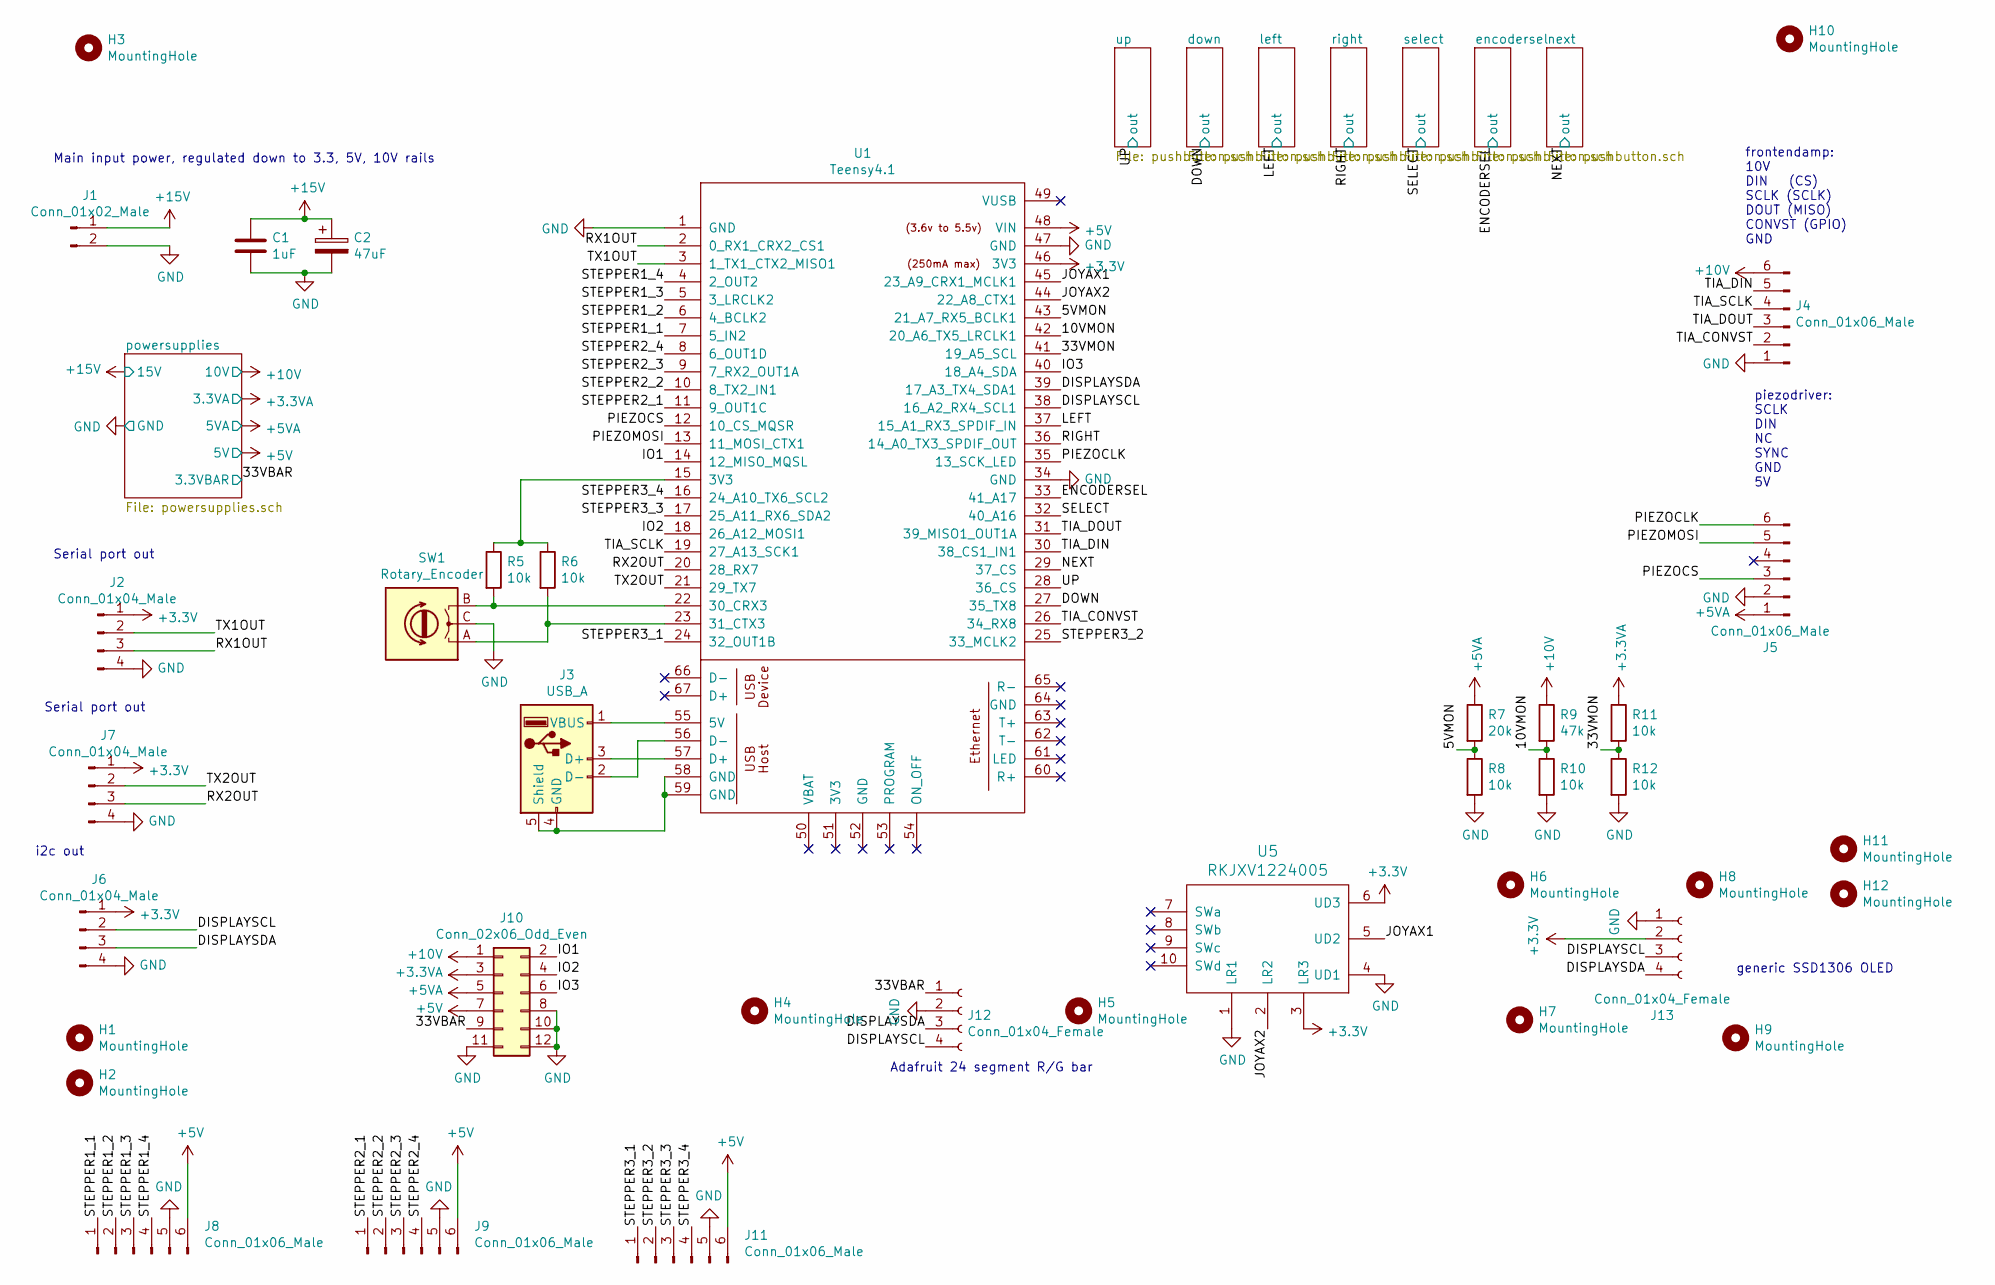
[picture p64: schematic userinterfacepcb.sch]

Parts:
C1: 1uF; C_0805_2012Metric_Pad1.15x1.40mm_HandSolder
C2: 47uF; CP_Radial_D6.3mm_P2.50mm
H1, H3, H5, H6, H8, H9, H11, H12: MountingHole; MountingHole_4.3mm_M4
H2, H4, H7, H10: MountingHole; MountingHole_3.2mm_M3
J1: Conn_01x02_Male; TerminalBlock_Phoenix_MKDS-1,5-2-5.08_1x02_P5.08mm_Horizont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
J2, J6, J7: Conn_01x04_Male; PinHeader_1x04_P2.54mm_Vertical
J3: USB_A; USB_A_Molex_105057_Vertical
J4, J5, J8, J9, J11: Conn_01x06_Male; PinHeader_1x06_P2.54mm_Vertical
J10: Conn_02x06_Odd_Even; PinHeader_2x06_P2.54mm_Vertical
J12, J13: Conn_01x04_Female; PinHeader_1x04_P2.54mm_Vertical
R5, R6, R8, R10, R11, R12: 10k; R_0805_2012Metric
R7: 20k; R_0805_2012Metric
R9: 47k; R_0805_2012Metric
SW1: Rotary_Encoder; RotaryEncoder_Alps_EC11E-Switch_Vertical_H20mm
U1: Teensy4.1; Teensy41
U5: RKJXV1224005

Connections:
+3.3VA: J10.3, R11.1; also elsewhere on the board
+3V3: J2.1, J6.1, J7.1, J13.2, U1.46 (3V3), U5.3 (LR3), U5.6 (UD3); also elsewhere on the board
+5V: J8.6, J9.6, J10.7, J11.6, U1.48 (VIN); also elsewhere on the board
+5VA: J5.1, J10.5, R7.1; also elsewhere on the board
+10V: J4.6, J10.1, R9.1; also elsewhere on the board
+15V: C1.1, C2.1, J1.1; also elsewhere on the board
/5VMON: R7.2, R8.1, U1.43 (21_A7_RX5_BCLK1)
/10VMON: R9.2, R10.1, U1.42 (20_A6_TX5_LRCLK1)
/33VBAR: J10.9, J12.1; also elsewhere on the board
/33VMON: R11.2, R12.1, U1.41 (19_A5_SCL)
/DISPLAYSCL: J6.2, J12.4, J13.3, U1.38 (16_A2_RX4_SCL1)
/DISPLAYSDA: J6.3, J12.3, J13.4, U1.39 (17_A3_TX4_SDA1)
/DOWN: U1.27 (35_TX8); also elsewhere on the board
/ENCODERSEL: U1.33 (41_A17); also elsewhere on the board
/IO1: J10.2, U1.14 (12_MISO_MQSL)
/IO2: J10.4, U1.18 (26_A12_MOSI1)
/IO3: J10.6, U1.40 (18_A4_SDA)
/JOYAX1: U1.45 (23_A9_CRX1_MCLK1), U5.5 (UD2)
/JOYAX2: U1.44 (22_A8_CTX1), U5.2 (LR2)
/LEFT: U1.37 (15_A1_RX3_SPDIF_IN); also elsewhere on the board
/NEXT: U1.29 (37_CS); also elsewhere on the board
/PIEZOCLK: J5.6, U1.35 (13_SCK_LED)
/PIEZOCS: J5.3, U1.12 (10_CS_MQSR)
/PIEZOMOSI: J5.5, U1.13 (11_MOSI_CTX1)
/RIGHT: U1.36 (14_A0_TX3_SPDIF_OUT); also elsewhere on the board
/RX1OUT: J2.3, U1.2 (0_RX1_CRX2_CS1)
/RX2OUT: J7.3, U1.20 (28_RX7)
/SELECT: U1.32 (40_A16); also elsewhere on the board
/STEPPER1_1: J8.1, U1.7 (5_IN2)
/STEPPER1_2: J8.2, U1.6 (4_BCLK2)
/STEPPER1_3: J8.3, U1.5 (3_LRCLK2)
/STEPPER1_4: J8.4, U1.4 (2_OUT2)
/STEPPER2_1: J9.1, U1.11 (9_OUT1C)
/STEPPER2_2: J9.2, U1.10 (8_TX2_IN1)
/STEPPER2_3: J9.3, U1.9 (7_RX2_OUT1A)
/STEPPER2_4: J9.4, U1.8 (6_OUT1D)
/STEPPER3_1: J11.1, U1.24 (32_OUT1B)
/STEPPER3_2: J11.2, U1.25 (33_MCLK2)
/STEPPER3_3: J11.3, U1.17 (25_A11_RX6_SDA2)
/STEPPER3_4: J11.4, U1.16 (24_A10_TX6_SCL2)
/TIA_CONVST: J4.2, U1.26 (34_RX8)
/TIA_DIN: J4.5, U1.30 (38_CS1_IN1)
/TIA_DOUT: J4.3, U1.31 (39_MISO1_OUT1A)
/TIA_SCLK: J4.4, U1.19 (27_A13_SCK1)
/TX1OUT: J2.2, U1.3 (1_TX1_CTX2_MISO1)
/TX2OUT: J7.2, U1.21 (29_TX7)
/UP: U1.28 (36_CS); also elsewhere on the board
GND: C1.2, C2.2, J1.2, J2.4, J4.1, J5.2, J6.4, J7.4, J8.5, J9.5, J10.8, J10.10, J10.11, J10.12, J11.5, J12.2, J13.1, R8.2, R10.2, R12.2, SW1.C, U1.1 (GND), U1.34 (GND), U1.47 (GND), U5.1 (LR1), U5.4 (UD1); also elsewhere on the board
unnamed: J3.1 (VBUS), U1.55 (5V)
unnamed: J3.2 (D-), U1.56 (D-)
unnamed: J3.3 (D+), U1.57 (D+)
unnamed: J3.4 (GND), J3.5 (Shield), U1.58 (GND), U1.59 (GND)
unnamed: R5.1, R6.1, U1.15 (3V3)
unnamed: R5.2, SW1.B, U1.22 (30_CRX3)
unnamed: R6.2, SW1.A, U1.23 (31_CTX3)

Notes on the sheet:
frontendamp: 10V DIN (CS) SCLK (SCLK) DOUT (MISO) CONVST (GPIO) GND
piezodriver: SCLK DIN NC SYNC GND 5V
Main input power, regulated down to 3.3, 5V, 10V rails
Serial port out
generic SSD1306 OLED
Adafruit 24 segment R/G bar
i2c out

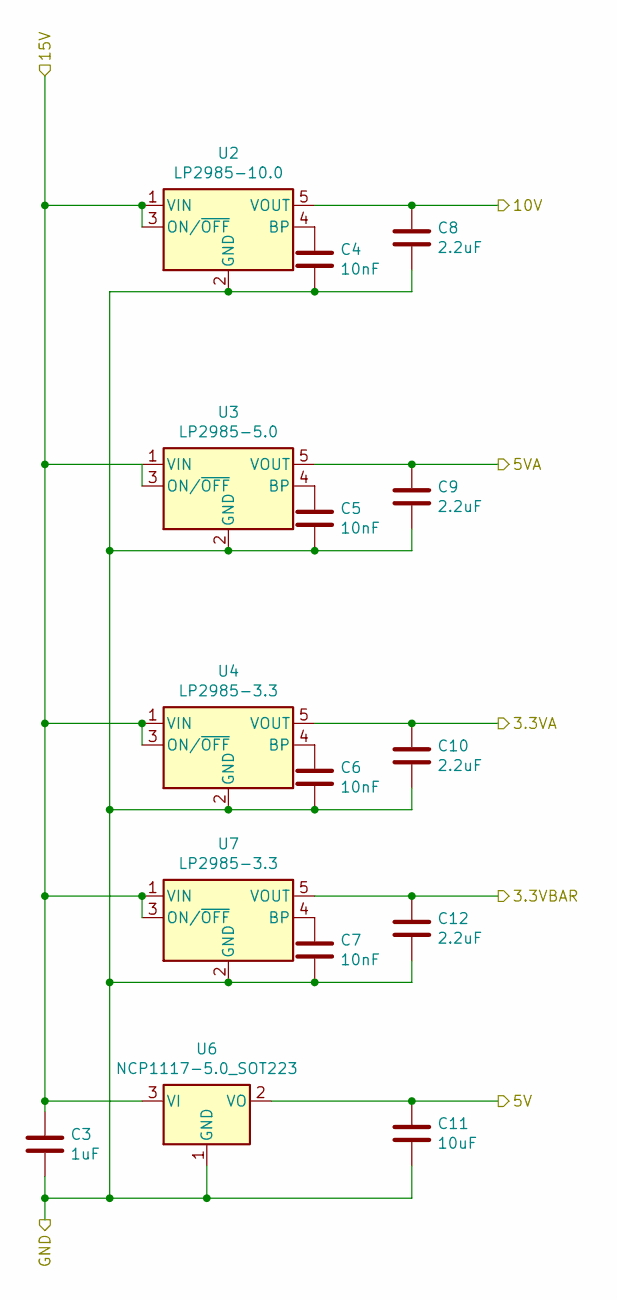
[picture p65: schematic powersupplies.sch]

Parts:
C3: 1uF; C_0805_2012Metric_Pad1.15x1.40mm_HandSolder
C4, C5, C6, C7: 10nF; C_0805_2012Metric_Pad1.15x1.40mm_HandSolder
C8, C9, C10, C12: 2.2uF; C_0805_2012Metric_Pad1.15x1.40mm_HandSolder
C11: 10uF; CP_Radial_D6.3mm_P2.50mm
U2: LP2985-10.0; SOT-23-5
U3: LP2985-5.0; SOT-23-5
U4, U7: LP2985-3.3; SOT-23-5
U6: NCP1117-5.0_SOT223; SOT-223-3_TabPin2

Connections:
+3.3VA: C10.1, U4.5 (VOUT); also elsewhere on the board
+5V: C11.1, U6.2 (VO); also elsewhere on the board
+5VA: C9.1, U3.5 (VOUT); also elsewhere on the board
+10V: C8.1, U2.5 (VOUT); also elsewhere on the board
+15V: C3.1, U2.1 (VIN), U2.3 (ON/~OFF~), U3.1 (VIN), U3.3 (ON/~OFF~), U4.1 (VIN), U4.3 (ON/~OFF~), U6.3 (VI), U7.1 (VIN), U7.3 (ON/~OFF~); also elsewhere on the board
/33VBAR: C12.1, U7.5 (VOUT); also elsewhere on the board
GND: C3.2, C4.2, C5.2, C6.2, C7.2, C8.2, C9.2, C10.2, C11.2, C12.2, U2.2 (GND), U3.2 (GND), U4.2 (GND), U6.1 (GND), U7.2 (GND); also elsewhere on the board
unnamed: C4.1, U2.4 (BP)
unnamed: C5.1, U3.4 (BP)
unnamed: C6.1, U4.4 (BP)
unnamed: C7.1, U7.4 (BP)

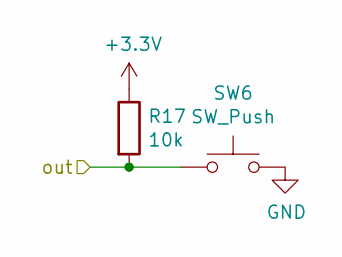
[picture p66: schematic pushbutton.sch]

Parts:
R13: 10k; R_0805_2012Metric
SW2: SW_Push; SW_PUSH_6mm_H8mm

Connections:
+3V3: R13.1; also elsewhere on the board
/UP: R13.2, SW2.1; also elsewhere on the board
GND: SW2.2; also elsewhere on the board

Parts of its further copies:
R14, R15, R16, R17, R18, R19: 10k; R_0805_2012Metric
SW3, SW4, SW5, SW6, SW7, SW8: SW_Push; SW_PUSH_6mm_H8mm

Connections of its further copies:
+3V3: R14.1, R15.1, R16.1, R17.1, R18.1, R19.1; also elsewhere on the board
/DOWN: R14.2, SW3.1; also elsewhere on the board
/ENCODERSEL: R19.2, SW8.1; also elsewhere on the board
/LEFT: R15.2, SW4.1; also elsewhere on the board
/NEXT: R18.2, SW7.1; also elsewhere on the board
/RIGHT: R16.2, SW5.1; also elsewhere on the board
/SELECT: R17.2, SW6.1; also elsewhere on the board
GND: SW3.2, SW4.2, SW5.2, SW6.2, SW7.2, SW8.2; also elsewhere on the board

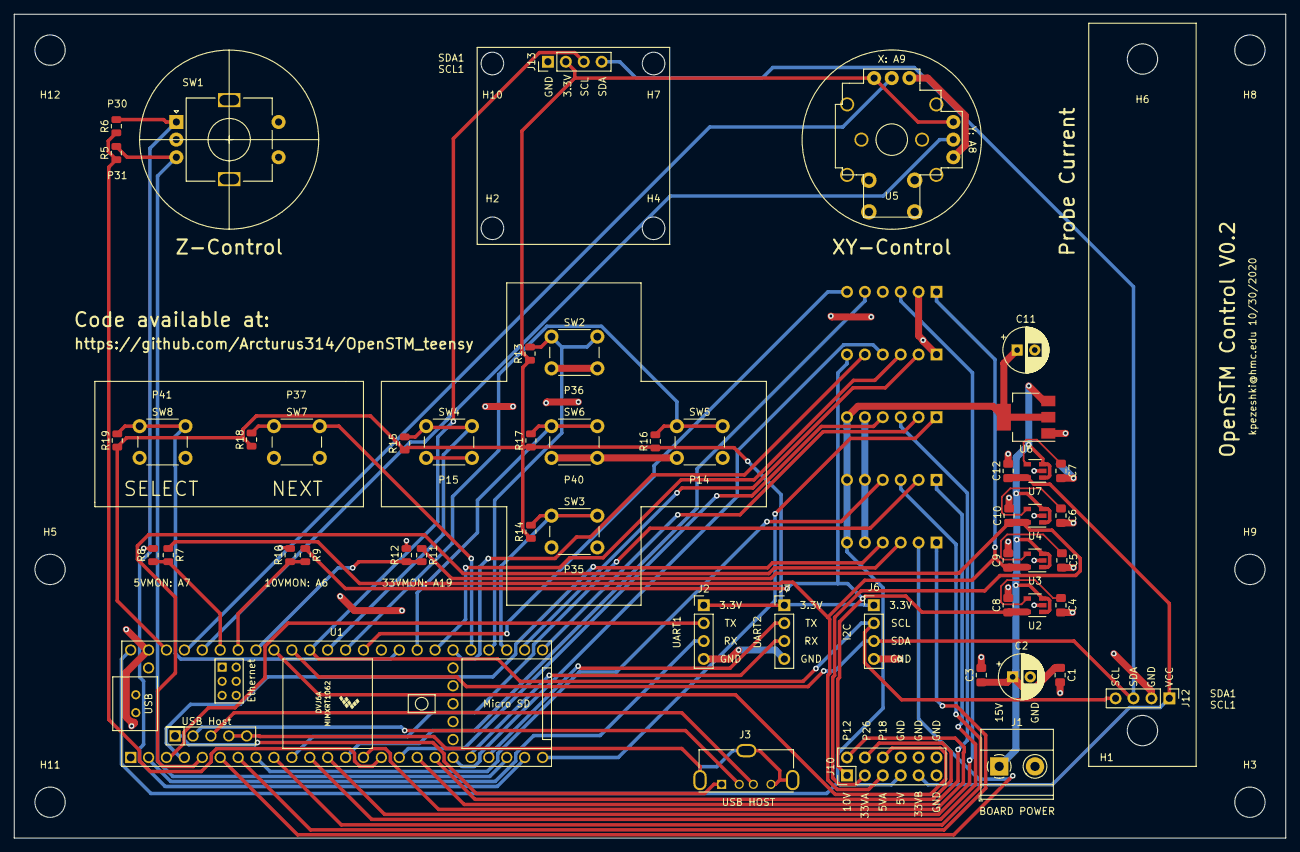
[picture p67: board userinterfacepcb.kicad_pcb from above]

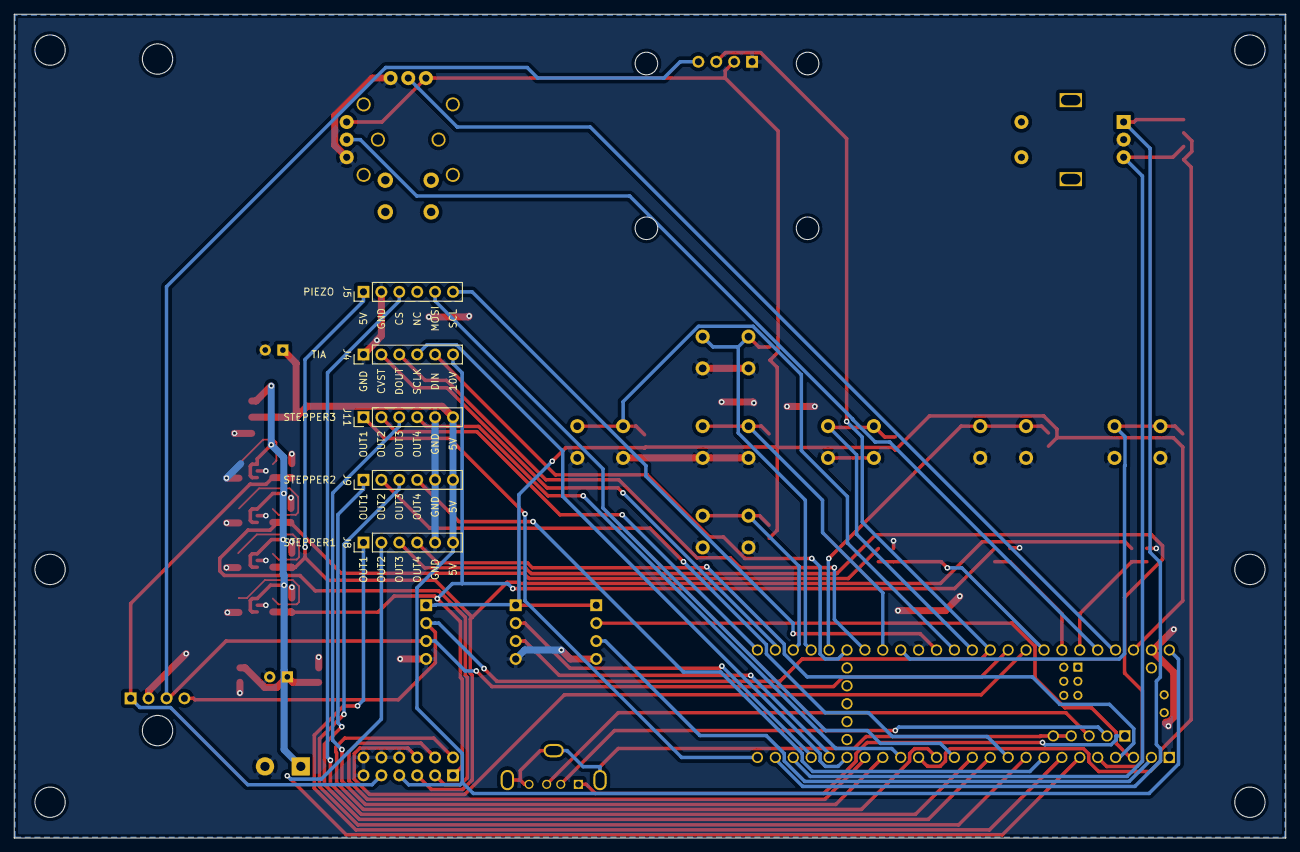
[picture p68: board userinterfacepcb.kicad_pcb from below]

Board: 2 copper layers, 180.3 x 116.8 mm, 67 parts (5 on the bottom side), 59 nets.
