Arcturus314/stm_all/stm/testscripts/ads8867read/ads8867read.ino

// ADS8867: clock idle low, shift out on pos edge, sample on neg edge -> SPI mode 0
// MSB FIRST
// hold DIN HIGH
// use CONVST as CS (active LOW)

#include <SPI.h>

#define CSPIN 19

void setup() {
  // put your setup code here, to run once:

  pinMode(CSPIN, OUTPUT);
  pinMode(13, OUTPUT);
  pinMode(12, OUTPUT);
  
  Serial.begin(9600);
  Serial.println("Basic DAC test with ADS8867");

  SPI.begin();
  SPI.beginTransaction(SPISettings(100000, MSBFIRST, SPI_MODE3));


}

void loop() {
  // put your main code here, to run repeatedly:
  digitalWrite(13, HIGH);
  digitalWrite(12, HIGH);

  int meanVal = 0;
  int16_t receivedVal = 0;

  for (int i = 0; i < 5; i++) {
    digitalWrite(CSPIN, LOW);
    delayMicroseconds(1);
    digitalWrite(CSPIN, HIGH);
    delayMicroseconds(1);
    digitalWrite(CSPIN, LOW);
    int16_t receivedVal_high = (int16_t) SPI.transfer(0xff);
    int16_t receivedVal_low  = (int16_t) SPI.transfer(0xff);
    delayMicroseconds(1);
    digitalWrite(CSPIN, HIGH);
    delayMicroseconds(1);
    digitalWrite(CSPIN, LOW);
    receivedVal = receivedVal_high << 8 | receivedVal_low;
    meanVal += receivedVal;
  }
    

  float receivedFloat = float(meanVal) * 3.3 / (float) 65536 / (float) 5.0;

  //Serial.print(receivedVal_high);
  //Serial.print(" ");
  //Serial.print(receivedVal_low);
  //Serial.print(" ");
  Serial.println(receivedFloat,5);

  
  digitalWrite(13, LOW);
  digitalWrite(12, LOW);
  delay(10);

}
