Arcturus314/stm_all/stm/testscripts/frontendamptest/frontendamptest.ino

// Distributed with a free-will license.
// Use it any way you want, profit or free, provided it fits in the licenses of its associated works.
// ADC121C021
// This code is designed to work with the ADC121C021_I2CADC I2C Mini Module available from ControlEverything.com.
// https://www.controleverything.com/content/Analog-Digital-Converters?sku=ADC121C021_I2CADC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

#include <Wire.h>

// ADC121C021 I2C address is 0x50(80)
#define Addr 0x54

void setup()
{
  // Initialise I2C communication as MASTER
  Wire.begin();
  // Initialise serial communication, set baud rate = 9600
  Serial.begin(9600);
  delay(300);
}

void loop()
{
  unsigned int data[2];
  // Start I2C Transmission
  Wire.beginTransmission(Addr);
  // Calling conversion result register, 0x00(0)
  Wire.write(0x00);
  // Stop I2C transmission
  Wire.endTransmission();

  // Request 2 bytes of data
  Wire.requestFrom(Addr, 2);

  // Read 2 bytes of data
  // raw_adc msb, raw_adc lsb
  if (Wire.available() == 2)
  {
    data[0] = Wire.read();
    data[1] = Wire.read();
  }
  // Convert the data to 12 bits
  int raw_adc = ((data[0] & 0x0F) * 256) + data[1];
  // Output data to serial monitor

  long total_adc = 0;
  for (int i = 0; i < 1; i++) {
    // Request 2 bytes of data
    Wire.requestFrom(Addr, 2);

    // Read 2 bytes of data
    // raw_adc msb, raw_adc lsb
    if (Wire.available() == 2)
    {
      data[0] = Wire.read();
      data[1] = Wire.read();
    }
    // Convert the data to 12 bits
    int raw_adc = ((data[0] & 0x0F) * 256) + data[1];

    total_adc += raw_adc;
  }

  Serial.println(float(total_adc / 1) / 4096.0 * 50.0);
  delay(10);
}
